KoneFly/eg4s20bg256-media-terminal/visual/pcb_sketch_renderer/reference/golden_overview.png

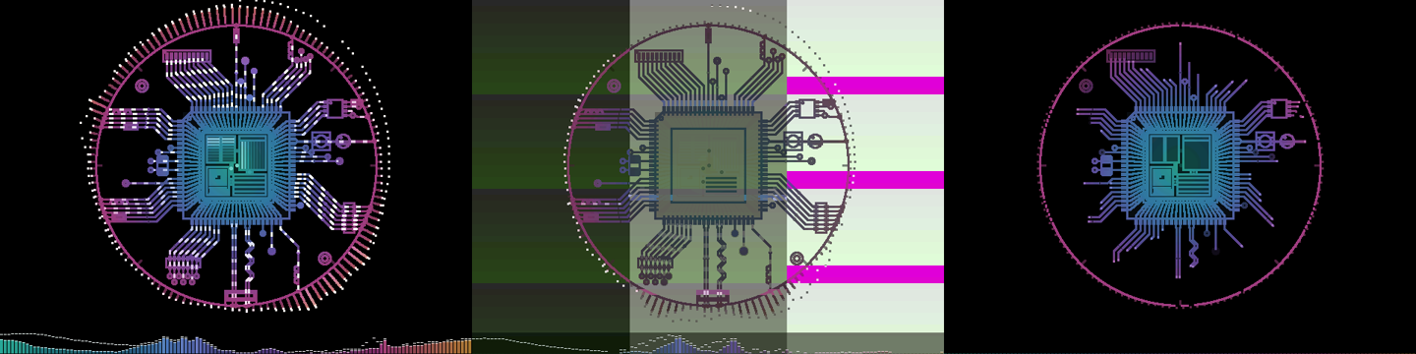
visual/pcb_sketch_renderer/reference/golden_overview.png
