KoneFly/eg4s20bg256-media-terminal/visual/pcb_dynamic_layer/doc/output/RESOURCE_REFACTOR_REPORT.md

# pcb_dynamic_layer W2 多周期资源重构记录

> 最后核对日期：2026-10-04  
> 维护者：pcb_dynamic_layer 执行方  
> 当前范围：W2 多周期版；W1 已归档出列。

用户批准移除超重的 W1，当前只投入 W2：长组合链切分为实际多拍，复用同构算术及工作缓冲，保持原 no_particles_v2 和 T1/T2 协议。

共享谱读注册、一个 DSP、9bit rise/fall 减法器、串行除法和读改写记录缓冲；配置集中限幅，按可达范围收敛内部位宽。ROM/地址规划保持等价，没有缩减柱数、三槽脉冲、四个彗星或改黄金。

最终最小硬门禁通过，4000 LUT 优化目标未达到。四轮原始 TD、具体数字、时序、告警和拍数统一登记于 W2_MULTICYCLE_REPORT.md / sim/td_result_mc.json，不重复维护数值表。最小预算余量有限，仍待规格方核定落点。

当前交付是 W2 多周期 RTL 和独立综合级测量；不定板、不集成。W1 原实现/证据在 archive/v2，解析式绘制只列二期候选。原 V1/V2 重构报告均保留在历史归档。

状态更新、RAM、黄金/TB 与归档各自职责清楚；共享算术、配置及记录缓冲减少重复。实现围绕本轮资源与时序门禁，没有增加未来绘制预留功能。
