KoneFly/eg4s20bg256-media-terminal/docs/中继板规格_v1冻结与v2设计.md

# 中继板规格（v1 冻结 + v2 设计）

> **合并版 2026-10-23**：本文件 = `音频采集板要求.md`（v1 冻结设计书）+ `麦克风中继板v2规格_20261020.md`（v2 设计）
> **第一部分 = v1 冻结引脚与板级要求（SSOT）**；**第二部分 = v2 改进设计**
> ⚠️ 引脚分配以第一部分为准，v2 不得改动

---

# 第一部分 · v1 冻结设计（原 `音频采集板要求.md`）

# 音频采集中继板需求（四路 I2S 数字麦克风）

> 更新 2026-10-14 ｜ 形态 = **四路 I2S 麦克风中继板**（**直接插到主板「连接器 J1」**）
> 状态：**供画中继板使用**；标【待确认】的项需先定值再落版。

---

## 1. 本方案内容

- 只做**一块四路中继板**：**1 个 2×20 母座插到「连接器 J1」** + **4 个 `INMP441` 模块座** + 去耦 + `SD` 下拉。
- **不画麦克风芯片板** —— 不做裸芯片贴装、不做模拟前端、不做板上声学开孔（进音由模块自身决定）。
- **不放任何 codec / DAC 芯片。**
- **输出侧不在本板**：扬声器现有 FPGA 板上已有，见 §8。
- 合规口径：麦克风属**传感器**；

---

## 2. 器件（**已定：`INMP441` 模块**）

| 项 | 手册值 | 对我们的意义 |
|---|---|---|
| 接口 | **24 bit 标准 I²S** | 直接进 FPGA，无需解调 |
| **供电** | **1.62 ~ 3.63 V** | **3.3 V 直供，免 LDO** |
| 电流 | 2.2 mA @3.3 V | 4 颗约 9 mA、8 颗约 18 mA |
| SNR / 灵敏度 | 61 dBA / −26 dBFS | 优于片内 ADC 的 8 bit |
| **`SCK` 频率** | **0.5 ~ 3.2 MHz** | 3.07~3.13 MHz（48 k×64）**已用掉上限的 96~98%** ⇒ 时钟质量必须保证（见 §4-C2） |
| **`WS` 频率** | **7.8 ~ 50 kHz** | 48 kHz 在范围内 |
| 数字电平 | V_IH ≥ 0.7×V_DD、V_IL ≤ 0.25×V_DD | 3.3 V 下与 J1 **直连兼容** |
| **群延迟** | **359 µs @48 kHz** | 频谱分析无所谓；**做 ANC / 音画同步须计入** |
| 数字滤波 | 内置高通 + 低通 | Q4 现场采集用；**内置滤波不构成"算法外包"**（见 §1 合规口径） |
| 进音 | **底部进音**（4.72×3.76×1 mm） | **⇒ 进音面朝向必须在装配时确认，见 §4-E1** |

**模块引出 6 脚**：`VDD` / `GND` / `SCK` / `WS` / `SD` / `L/R`（**`CHIPEN` 未引出，应为模块内部已使能** —— 见 §10）。

**`L/R` 接法**：本方案各麦**独占一根 `SD`** ⇒ **`L/R` 一律接 GND**（占左时隙），FPGA 只读左时隙。

**为什么不"一左一右"**：`L/R` 只决定"数据在 I2S 帧的**哪个半周期**推上线"，**不产生立体声**（INMP441 是单声道麦）。一左一右**唯一的作用是让两颗麦共用一根 `SD` 线（省线）**；各自独占 `SD` 时，左右只是换个时隙，**数据完全一样、效果不会更好**。J1 有 36 路而本板只用 9 个，**不缺线 ⇒ 不为省 2 根线引入分时解复用的复杂度**。

---

## 3. 接口与连线

**模块脚名对照**：模块的 `SCK` = 我们的 **`BCLK`**（位时钟）；`WS` = **`LRCK`**（帧时钟）；`SD` = 数据；`L/R` **接 GND**。**接 J1 的脚位见 §12.2。**

```text
FPGA --BCLK(位时钟)--+----+----+----+    两线共享
FPGA --LRCK(帧时钟)--+----+----+----+
                     |    |    |    |
                   [麦1][麦2][麦3][麦4]
                     |    |    |    |
FPGA <--SD0----------+    |    |    |    各麦各自一根数据线
FPGA <--SD1---------------+    |    |
FPGA <--SD2--------------------+    |
FPGA <--SD3-------------------------+
```

各麦共享同一对 `BCLK`/`LRCK` ⇒ **同一时刻采样，是真正的同时采样**。

**【必办】每根 `SD` 必须对地下拉**：麦在不驱动的那半周期 `SD` **呈高阻 ⇒ 线浮空**，会造成不确定读数与输入缓冲额外翻转电流。**中继板上给每根 `SD` 加 `100 kΩ` 对地下拉**（或改由 FPGA 内部弱下拉，二选一）。同时 **FPGA 侧只在左时隙采样**。

---

## 4. 中继板设计要求（**重点**）

### A. 电气安全

| # | 事项 |
|---|---|
| **A1【致命】** | **照实物缺口核对第一脚方向** —— 手册原文：**J1 第一脚在正方向左上**（J2 在**右下**，两口相反）。**插反 = 5 V / 3.3 V 灌进 IO ⇒ 可能烧 FPGA** |
| **A2【致命】** | **脚 11 是 5 V，一个 IO 都不许接**；取电只能用**脚 29（3.3 V）**。即使模块标注可用 5 V，**也只用 3.3 V** |
| **A3【致命】** | **模块座方向不能反** —— 模块丝印为 `GND VDD SD`（上排）/ `L/R WS SCK`（下排）；**座子接反 = VDD/GND 对调 ⇒ 烧模块**。逐块照丝印核 |
| A4 | **不要带电插拔**（J1 无保护电路） |

### C. 信号完整性

| # | 事项 |
|---|---|
| **C1** | **每根 `SD` 加 100 kΩ 下拉**（见 §3） |
| **C2【注意】** | **`BCLK` 余量极小**（3.07~3.13 MHz vs 手册上限 3.2 MHz）⇒ **源端串 22~33 Ω**、避免长支线、**不与 `SD` 长距离并行** |
| C3 | **回流路径连续**：不在 `BCLK`/`SD` 下方开槽；保留**完整地平面** |
| C4 | **不需要等长** —— 3 MHz 在板级属低频段，走线差折算到时间是亚纳秒量级，抠等长是白费功夫 |

### D. 电源与去耦

| # | 事项 |
|---|---|
| D1 | **每颗麦 `100 nF` 紧靠 `VDD`**（位置比容值重要）；中继板另加 **1 颗 `10 µF`** 作板级储能 |
| D2 | **3.3 V 电流要实测**：4 路约 9 mA、8 路约 18 mA；**手册未给脚 29 的电流指标** ⇒ 首次上电测该脚电压跌落【待确认】 |
| D3 | **J1 只有 2 个 GND（脚 12、30）** ⇒ 4~8 颗麦的回流都挤这两个脚。**可选**：在中继板上把若干空闲脚并联接 GND 增加回流 —— 但**那样 FPGA 侧这些脚必须保持未使用、不得被固件驱动**（须与固件方约定） |

### E. 声学与机械

| # | 事项 |
|---|---|
| **E1【致命】** | **先肉眼确认模块的进音面** —— INMP441 是**底部进音**（声音从芯片**背面**进）。若模块把芯片贴在板正面，则**进音孔在模块朝下那一面** ⇒ **中继板对应位置必须开孔、或让模块与中继板之间留出空腔**，否则**进音被堵、灵敏度骤降** |
| E2 | **四颗朝向一致**（不一致会造成通道间幅相差异） |
| E3 | **别把进音面贴死在桌面/机箱上**，留出进音空间 |
| E4 | **排针受力**：中继板靠 J1 一排针悬空支撑 ⇒ 建议加**支撑柱/定位孔**或控制悬臂长度，别让模块重量全压在排针上 |
| E5 | **模块间距**：留出各自进音空腔，不互相遮挡 |

### F. 可测性与可扩展

| # | 事项 |
|---|---|
| F1 | **留测试点**：`BCLK`、`LRCK`、**每根 `SD`** 各留一个测试焊盘（调试必用示波器/逻辑分析仪） |
| F2 | **一并引出 8 路**：SD4~SD7 = 脚 **21（G16）/ 23（K15）/ 25（H15）/ 27（K16）**，与备用 GND 一起引到排针 ⇒ 以后扩 8 路不用重画 |
| F3 | **丝印**：每个模块座旁标 `MIC1~4` 与六脚定义；板上标 `J1(连接器)` 与**第一脚三角标记** |

### G. 器件与工艺

| # | 事项 |
|---|---|
| G1 | **ESD**：MEMS 麦是静电敏感器件（手册有 ESD CAUTION）⇒ 焊接/装配做静电防护 |
| G2 | **首版用座子**（便于换型号/换位置），不直焊 |
| G3 | **引脚总数核对**：`BCLK` 1 + `LRCK` 1 + `SD` 4 + 3.3 V 1 + GND 2 = **9 个脚**（另加 4 个下拉电阻与去耦） |

---

## 5. 规模与扩展

- 首版 **4 路**（`SD0~SD3`）；
- **板上同时引出 `SD4~SD7`**（脚 21/23/25/27）⇒ 可扩到 **8 路**；
- 上限 8 路（FPGA 侧接收逻辑与数据线数均充裕）。

---

## 6. 电源

3.3 V 单电源（J1 脚 29），**不需要高精度基准**；中继板保留完整地平面。

---

## 7. FPGA 侧接口约定（了解即可，不需实现）

- `BCLK` / `LRCK`：由 FPGA 从 50 MHz 分频产生，**全通道共享**；名义 48 kHz 量级，实际速率随分频比（**现有音频链本就用非标准速率，不是新问题**）。
- 接收：**一份 I2S 接收器**（`BCLK`/`LRCK` 计数 + 每通道一个移位寄存器），**按 `LRCK` 取左时隙**，送入频谱链。
- **不需要 CIC 抽取滤波** —— I2S 麦内部已输出 PCM。
- 数据格式（标准 I2S / 左对齐、MSB 位置）**按所选型号手册对齐**。
- 硬件只需保证：**时钟干净、电源干净、走线合理**。

---

## 12. J1 引脚分配（**连接器 J1**）

### 12.1 概况

| 口 | 网络名 | IO 数 | 电源脚 | 地脚 | 状态 |
|---|---|---|---|---|---|
| **J1** | `GPIOA_0` ~ `GPIOA_35` | 36 | 脚 11 = 5V，脚 29 = 3.3V | 脚 12、30 | **本板使用** |
| J2 | `GPIOB_0` ~ `GPIOB_35` | 36 | 同上 | 同上 | **全空，备用** |

2×20 IDC（40 脚），**IO 电平 3.3 V**；板内到 FPGA 按差分等长走线，**本板用单端，不需要差分对**。

**占用情况**：本项目已用引脚（HDMI-B、TF、按键、拨码、LED、晶振、复位、DDC，以及双板链路用的 **HDMI-A 连接器**）**没有一个落在 J1 / J2 上**。

### 12.2 四路分配（含 8 路预留）

| 用途 | J1 脚位 | 网络名 | FPGA 球脚 |
|---|---|---|---|
| **`BCLK`**（位时钟，共享） | **1** | `GPIOA_0` | **D14** |
| **`LRCK`**（帧时钟，共享） | **3** | `GPIOA_2` | **G12** |
| **MIC1 `SD`** | **5** | `GPIOA_4` | **H13** |
| **MIC2 `SD`** | **7** | `GPIOA_6` | **J14** |
| **MIC3 `SD`** | **9** | `GPIOA_8` | **K12** |
| **MIC4 `SD`** | **13** | `GPIOA_10` | **M14** |
| MIC5 `SD`（预留） | 21 | `GPIOA_18` | G16 |
| MIC6 `SD`（预留） | 23 | `GPIOA_20` | K15 |
| MIC7 `SD`（预留） | 25 | `GPIOA_22` | H15 |
| MIC8 `SD`（预留） | 27 | `GPIOA_24` | K16 |
| **3.3 V 取电** | **29** | VCC_3V3 | — |
| **GND** | **12**、**30** | GND | — |

**⇒ 6 根信号全在奇数脚（1/3/5/7/9/13），一列排完，走线最省。**

### 12.3 J1 完整对照（**左列 = 奇数脚，右列 = 偶数脚，自上而下**）

| 左列 | 右列 |
|---|---|
| **1** `GPIOA_0` **D14** —— **`BCLK`** | **2** `GPIOA_1` G11 —— 备用 |
| **3** `GPIOA_2` **G12** —— **`LRCK`** | **4** `GPIOA_3` F13 —— 备用 |
| **5** `GPIOA_4` **H13** —— **MIC1 `SD`** | **6** `GPIOA_5` H14 —— 备用 |
| **7** `GPIOA_6` **J14** —— **MIC2 `SD`** | **8** `GPIOA_7` J13 —— 备用 |
| **9** `GPIOA_8` **K12** —— **MIC3 `SD`** | **10** `GPIOA_9` L14 —— 备用 |
| 11 `VCC5V` —— **【禁接】** | **12 `GND`** —— **回地（必接）** |
| **13** `GPIOA_10` **M14** —— **MIC4 `SD`** | 14 `GPIOA_11` P11 —— **留空（ADC 球脚）** |
| 15 `GPIOA_12` L10 —— **留空（ADC 球脚）** | 16 `GPIOA_13` M10 —— **留空（ADC 球脚）** |
| 17 `GPIOA_14` D16 —— 备用 | 18 `GPIOA_15` E15 —— 备用 |
| 19 `GPIOA_16` F14 —— 备用 | 20 `GPIOA_17` F15 —— 备用 |
| **21** `GPIOA_18` **G16** —— MIC5（预留） | 22 `GPIOA_19` G14 —— 备用 |
| **23** `GPIOA_20` **K15** —— MIC6（预留） | 24 `GPIOA_21` J16 —— 备用 |
| **25** `GPIOA_22` **H15** —— MIC7（预留） | 26 `GPIOA_23` H16 —— 备用 |
| **27** `GPIOA_24` **K16** —— MIC8（预留） | 28 `GPIOA_25` M16 —— 备用 |
| **29 `3.3V`** —— **取电（必接）** | **30 `GND`** —— **回地（必接）** |
| 31 `GPIOA_26` M15 —— 备用 | 32 `GPIOA_27` L16 —— 备用 |
| 33 `GPIOA_28` N16 —— 备用 | 34 `GPIOA_29` N14 —— 备用 |
| 35 `GPIOA_30` P16 —— 备用 | 36 `GPIOA_31` P15 —— 备用 |
| 37 `GPIOA_32` R16 —— **留空（ADC 球脚）** | 38 `GPIOA_33` R15 —— 备用 |
| 39 `GPIOA_34` T15 —— 备用 | 40 `GPIOA_35` R14 —— 备用 |

---

# 第二部分 · v2 设计规格

# 麦克风中继板 v2 设计规格（2026-10-21 定稿）

> **签发**：浮浮酱（架构方）｜ **执行**：硬件队友
> **依据**：`docs/音频采集板要求.md`（v1 设计书）+ 2026-10-20/21 现场实测结论
> **状态**：**v1 已装机运行正常**；v2 为改进版，**不改任何 FPGA 引脚分配**
> **本文覆盖：引脚、布局、间距、信号完整性、电源、机械、丝印、测试点**

---

## 0. ⛔ 铁律：引脚分配一位都不能改

**依据（R32 实测失败）**：仅把 `audio_din` 从 G16 改到 P4 ⇒ **Setup 0.211 → 0.132 ns**，欠门禁 0.068，直接 FAIL、无 bit。

| 信号 | J1 脚 | 球脚 | 方向 |
|---|---|---|---|
| **BCLK**（共享） | **1** | **D14** | FPGA → 模块 |
| **LRCK**（共享） | **3** | **G12** | FPGA → 模块 |
| **MIC1 `SD`** | **5** | **H13** | 模块 → FPGA（**ANC 误差麦**） |
| **MIC2 `SD`** | **7** | **J14** | 模块 → FPGA |
| **MIC3 `SD`** | **9** | **K12** | 模块 → FPGA |
| **MIC4 `SD`** | **13** | **M14** | 模块 → FPGA |
| **DIN**（功放输出） | **21** | **G16** | **FPGA → 功放（输出！）** |
| 3.3 V | 29 | — | 电源 |
| GND | 12、30 | — | 电源 |

**⚠️ G16 已从「MIC5 预留输入」改为「DIN 输出」** ⇒ 第 5 个麦克风**绝不能**接 J1-21。

---

## 1. 保留 v1 的全部设计

| 项 | 说明 |
|---|---|
| **J1 2×20 母座** | ⚠️ **第一脚在正方向左上**，板上必须有三角标记 |
| **4 个 INMP441 模块座** | 六脚丝印：上排 `GND VDD SD`／下排 `L/R WS SCK` |
| **每路 `SD` 的 100 kΩ 下拉** | 麦克风半周期呈高阻，必须下拉 |
| **每模块 VDD 就近 0.1 µF 去耦** | 见 §6 |
| **进音开孔 / 空腔** | ⚠️ INMP441 **底部进音**，孔在芯片朝下那面 |
| **四颗朝向一致** | 避免通道间幅相差异 |
| **支撑柱** | 别让模块重量全压在排针上 |
| **丝印** | 每座旁标 `MIC1~4` + 六脚定义 |

---

## 2. ⭐ 新增 A：功放接口（2×4 排针，丝印 `AMP`）

### 2.1 排针定义

| 脚 | 信号 | 说明 |
|---|---|---|
| 1 | BCLK | ← J1-1 |
| 2 | LRCK | ← J1-3 |
| 3 | **DIN** | ← **J1-21（G16）** |
| 4 | GND | ← J1-12/30 |
| 5 | 3.3 V | ← J1-29（供 SD 选择） |
| 6 | **SD 分压点 1.055 V** | 见 §2.3 |
| 7 | GND | 电源回路 |
| 8 | 备用 | 预留第二个功放 |

### 2.2 扩流与滤波（**必做**）

| 元件 | 值 | 位置 | 原因 |
|---|---|---|---|
| **电解电容** | **100 µF / 16 V** | 功放 VIN 与 GND 间，靠近接口 | D 类功放电流脉冲大，压降会带出「嗡嗡」声 |
| **陶瓷电容** | **0.1 µF** | 同上，紧邻 | 高频去耦 |
| **串阻** | **22~33 Ω** | BCLK / LRCK / DIN 各一个，靠 FPGA 侧 | 抑制长线振铃 |

> v1 **没有**串阻，系统工作正常 ⇒ 属增强项；但 **v2 因负载增加（见 §2.2.1），建议改为必做**。
> 位号放 0402 焊盘，**兼容 0 Ω 跳线**（万一反而变差可直接短接）。

### 2.2.1 ⚠️ 四麦 + 功放后的 BCLK / LRCK 扇出

| 项 | v1（3 麦 + 1 功放 = 4） | **v2（4 麦 + 1 功放 = 5）** |
|---|---|---|
| BCLK 频率 | 3.07~3.13 MHz | 同 |
| 负载数 | 4 | **5** |
| 风险 | 可接受 | **扇出增加，必须串阻** |

> 依据：`音频采集板要求.md` **§C2** —— BCLK 余量极小（3.07~3.13 MHz vs 手册上限 3.2 MHz）。

### 2.3 SD 分压与切换

**MAX98357A 的 `SD` 是电压门限选择，不是普通高低电平：**

| SD 电压 | 功能 |
|---|---|
| **< 0.16 V（GND）** | ⛔ **关断，完全无声** |
| 0.16 ~ 0.77 V | (L+R)/2 混合（听不出对比） |
| **0.77 ~ 1.4 V** | ✅ **右槽 = POST（滤波后）** |
| **> 1.4 V（3.3 V）** | ✅ **左槽 = RAW（滤波前）** |

**分压电路（板上固定焊接）**：

```text
3.3 V ── 100 kΩ ──┬── SD 分压点（1.055 V）
                  │
                47 kΩ
                  │
                 GND

标称 1.055 V；最坏偏差（±5%）0.935 ~ 1.185 V，仍在 0.77~1.4 V 内
```

**⚠️ 为什么不用 100k+33k**：标称 0.819 V 看似够，但最坏会掉到 **0.721 V**，跌破 0.77 V 门限 ⇒ 变成「(L+R)/2 混合」⇒ **听不出对比**。

**切换方式：单刀双掷拨动开关（SPDT，ON-ON）**

```text
              ┌── ① 3.3 V ──────→ RAW（滤波前）
   拨动开关 ──┤
              └── ③ 分压 1.055 V ─→ POST（滤波后）
                     │
                   ②（公共端）──→ 功放 SD
```

| 板上设计 | 说明 |
|---|---|
| 预留 **3P** 位 | `3.3V` / `SD` / `分压点`，可插开关或跳线帽 |
| 开关规格 | `SS-12D00` 类，**2 位 3 脚 ON-ON** |
| ⛔ 不要 ON-OFF-ON | 中间档 SD 悬空，音量异常 |
| ⛔ 不要引出 GND 档 | GND = 关断静音，容易误判为"功放坏了" |

> 不装开关时：跳线帽短接「3.3 V — SD」固定 RAW（保底演示够用）。

---

## 3. ⭐ 新增 A2：误差麦接口（6P 排针，丝印 `ERROR MIC`）

### 3.1 为什么必须走线缆

**ANC 要求误差麦与扬声器距离 3~8 cm**。若焊死在板上而喇叭在别处 ⇒ 距离不可控 ⇒ **ANC 完全失效**。

### 3.2 排针定义

| 脚 | 信号 | 来源 |
|---|---|---|
| 1 | **GND** | J1-12/30 |
| 2 | **VDD** | J1-29（3.3 V） |
| 3 | **SD** | **J1-5（H13）** |
| 4 | **L/R** | GND（固定左槽） |
| 5 | **WS** | J1-3（G12） |
| 6 | **SCK** | J1-1（D14） |

### 3.3 与其余三麦的关系

| 通道 | v2 形式 | 用途 |
|---|---|---|
| **MIC1** | ⭐ **6P 排针 + 线缆** | **ANC 误差麦（可移动）** |
| MIC2/3/4 | 板上模块座 | 三麦均值 |

> **RTL 依据**：`slave_audio_demo_top.v:236` 的 `mic_three_mean_t16` **只取 `pcm1/pcm2/pcm3`**，`pcm0`（MIC1）仅作调试输出 ⇒ **零冲突**。

**丝印必须写**：`ERROR MIC / ANC` + 「使用时放在扬声器前方 3~8 cm」+「不用时不插，不影响三麦均值」。

---

## 4. ⭐ 麦克风布局与间距（**v2 新增**）

### 4.1 核心矛盾

| 麦克风 | 位置由谁决定 | 要求 |
|---|---|---|
| **MIC1（误差麦）** | **扬声器的位置** | 离喇叭 **3~8 cm** |
| **MIC2/3/4（采集均值）** | **噪声场的位置** | **远离喇叭**（否则频谱被自己输出占满） |

**⇒ 两个要求相反。这正是不建议 MIC1 焊在板上的原因。**

### 4.2 间距要求（三层约束）

| # | 距离 | 要求 | 依据 |
|---|---|---|---|
| **1** | **MIC1 ↔ 扬声器** | **30 ~ 80 mm** | ANC 有效区仅在声源附近；`D-72` 账 6 的 500 Hz 相位预算允许 |
| **2** | **MIC2/3/4 ↔ 扬声器** | **≥ 150 mm** | 喇叭输出会直接进这三路，污染频谱 |
| **3** | **MIC1 ↔ 最近的 MIC2/3/4** | **≥ 100 mm** | 保证三麦在 ANC 安静区之外 |

### 4.3 三麦（MIC2/3/4）内部排布

| 项 | 建议 |
|---|---|
| 两两间距 | **30 ~ 50 mm** |
| 排布 | **三角形**（非直线 —— 直线易同相叠加） |
| 朝向 | 四颗**完全一致** |
| 与噪声源距离 | 大致相等，避免某一路偏响拉偏均值 |

### 4.4 若强行全部上板：板长需要 ≥120 mm

| 板长 | 可实现的 MIC1↔MIC2 距离 | 评价 |
|---|---|---|
| 60 mm | ≈ 45 mm | ❌ 不够 100 mm |
| 80 mm | ≈ 65 mm | ⚠️ 勉强 |
| 100 mm | ≈ 85 mm | 🟡 接近 |
| **120 mm** | ≈ 105 mm | ✅ 达标 |

**布局示意**：

```text
        ┌──────────────────────────────────┐
        │  ●MIC2        ●MIC3              │  三麦区
        │                                  │  （三角形）
        │  ●MIC4                           │
        │                                  │
        │  ═══════════ 分隔带 ═══════════   │  间距 ≥100 mm
        │                                  │
        │                        ●MIC1     │  误差麦区
        └──────────────────────────────────┘
                                  ↕ 30~80 mm
                              [ 扬声器 ]
```

**⇒ 推荐仍是 §3 的「MIC1 走线缆」，板长可回到 60~80 mm。**

---

## 5. ⭐ 信号完整性（**v2 强化**）

| # | 规则 | 原因 |
|---|---|---|
| **S1** | **BCLK / LRCK 源端串 22~33 Ω**（靠 FPGA 侧） | 频率 3.07~3.13 MHz，上限 3.2 MHz，余量极小 |
| **S2** | **走线尽量短**（<20 mm 至各模块座） | 长支线造成振铃/过冲 |
| **S3** | **`SD` 不得与 `BCLK` 长距离并行** | BCLK 会耦合进高阻的 SD |
| **S4** | **保持完整地平面** | 不在 BCLK/SD 下方开槽，保证回流连续 |
| **S5** | **不需要等长** | 3 MHz 在板级属低频段，差折算到时间是亚纳秒量级，抠等长是白费功夫 |
| **S6** | **每路 `SD` 留 100 kΩ 下拉** | 半周期高阻，防浮空 |
| **S7** | **功放 BCLK/LRC 分支也要串阻** | 与 §2.2.1 的 5 负载配合 |

---

## 6. ⭐ 电源与去耦

| # | 项 | 规格 |
|---|---|---|
| **P1** | 麦克风供电 | **3.3 V 单电源**（INMP441 宽压 1.62~3.63 V，免 LDO） |
| **P2** | 每模块去耦 | **0.1 µF**，紧贴 `VDD`-`GND` |
| **P3** | 总入口去耦 | **10 µF 电解 + 0.1 µF 陶瓷** |
| **P4** | **功放不从中继板取电** | 功放 VCC 走**独立 5V**（USB 只有 500 mA，功放峰值 **≈0.73 A**） |
| **P5** | **功放 VIN 就近去耦** | **100 µF + 0.1 µF**（§2.2） |
| **P6** | ⛔ **J1-11（VCC5V）绝不接任何线** | 致命（A2） |

**⚠️ 为什么功放不能用 FPGA 的 5V**：
1. 本板**只能 USB 供电**（板卡手册），USB 2.0 = **500 mA @ 5 V = 2.5 W**
2. 功放峰值 **0.73 A** ⇒ 单项就超容量
3. D 类功放电流脉冲会污染 5V 轨 → 经 LDO 传入 FPGA 的 3.3V → **时序劣化 / 音频自激**

---

## 7. ⭐ 新增 B：把剩余 IO 全部引出

| 类别 | J1 脚 | 引出方式 |
|---|---|---|
| 已用功能脚 | 1/3/5/7/9/13/21 | 正常接线 |
| **备用 MIC5~8** | **23 / 25 / 27** | 3P 排针 + GND（**21 已给 DIN**） |
| **普通 GPIO** | 2/4/6/8/10/17/18/19/20/22/24/26/28 | **2×7 排针** |
| 电源 | 12 / 29 / 30 | 3.3 V × 2 + GND × 2 |
| ⛔ **VCC5V** | **11** | **绝不引出** |
| ⛔ **ADC 球脚** | **14（P11）/ 16（M10）** | **留空不引出** |

**丝印**：每个引出排针旁标 **J1 脚号 + 球脚号**（如 `23/K15`）。

---

## 8. ⭐ 新增 C：测试点

| 测试点 | 形式 | 用途 |
|---|---|---|
| **BCLK / LRCK** | 测试焊盘 | 验证 3.07~3.13 MHz / 48 kHz |
| **每路 SD（MIC1~4）** | 测试焊盘 | 确认四麦都有数据 |
| **DIN（G16）** | 测试焊盘 | ⭐ 确认 I2S 输出有波形（功放不响时第一查这个） |
| **SD 分压点** | 测试焊盘 | 验证 1.055 V（误差 <5% 才装机） |
| **GND 测试柱** | **大焊盘或铜柱** | ⭐ **示波器探针接地，必须有** |

---

## 9. ⭐ 机械与工艺

| # | 项 | 要求 |
|---|---|---|
| **M1** | **进音开孔 / 空腔** | 每颗模块对应位置开孔或留空腔，**不能用双面胶封死进音面** |
| **M2** | **支撑柱** | 中继板靠 J1 一排针悬空支撑 ⇒ 加支撑柱/定位孔，别让模块重量全压在排针上 |
| **M3** | **四颗朝向一致** | 上下不能反 |
| **M4** | **ESD 防护** | MEMS 麦是静电敏感器件，焊接/装配做静电防护 |
| **M5** | **首版用座子** | 便于换型号/换位置，不直焊 |
| **M6** | **模块间距** | 留出各自进音空腔，不互相遮挡 |

---

## 10. ⚠️ 五条必须写进丝印的提醒

| # | 提醒 | 后果 |
|---|---|---|
| **A1** | **J1 第一脚在正方向左上** | 插反 = 5 V / 3.3 V 灌进 IO ⇒ **烧 FPGA** |
| **A2** | **J1-11 是 VCC5V，一个 IO 都不许接** | 短路 |
| **A3** | **模块座方向不能反** | VDD/GND 对调 ⇒ **烧模块** |
| **A4** | **J1-21（G16）是输出（DIN）** | 接麦克风会与输出对顶 ⇒ **可能烧器件** |
| **A5** | **误差麦（ERROR MIC）使用时要靠近扬声器 3~8 cm** | 距离不对 ANC 无效 |

---

## 11. 不改的部分（明确边界）

| 项 | 状态 |
|---|---|
| FPGA 引脚分配 | ⛔ **一位不改** |
| MIC 数量 | 4 路（MIC1~4） |
| BCLK / LRCK 频率 | 3.07~3.13 MHz / 48 kHz |
| I2S 采样率 | 48,076.923 Hz |
| 麦克风供电 | 3.3 V 单电源 |

---

## 12. ✅ 打样前检查清单

**电气**
- [ ] J1 第一脚位置正确（左上），有三角丝印
- [ ] MIC1~4 的 `SD` 各接 100 kΩ 下拉
- [ ] 每模块 VDD 就近 0.1 µF
- [ ] 总入口 10 µF + 0.1 µF
- [ ] BCLK/LRCK 串阻位已留（22~33 Ω，兼容 0Ω）
- [ ] 功放 VIN 100 µF + 0.1 µF
- [ ] SD 分压 100k + 47k（**不是 33k**），测点预留
- [ ] J1-11 未引出、未接线
- [ ] ADC 球脚（14/16）留空

**接口**
- [ ] `AMP` 2×4 排针，脚位与 §2.1 一致
- [ ] `ERROR MIC` 6P 排针，脚位与 §3.2 一致
- [ ] 扩展 IO 排针已引（含 MIC5~8 的 23/25/27）
- [ ] 测试点：BCLK / LRCK / 4×SD / DIN / SD 分压点 / GND 柱

**机械**
- [ ] 进音开孔/空腔
- [ ] 支撑柱位
- [ ] 模块座丝印 `MIC1~4` + 六脚定义

**上电前**
- [ ] 只用 3.3V 供电验证：量 J1-29 = 3.2~3.35 V
- [ ] 量 SD 分压点 = 1.0~1.1 V
- [ ] 量 `mic_bclk` 波形 = 3.07~3.13 MHz（**首件必做，映射错会误判**）

---

*浮浮酱 ｜ 2026-10-21 ｜ 引脚不动、间距够远、地要干净、丝印要醒目。*
