KoneFly/eg4s20bg256-media-terminal/docs/网站名称简介_已提交版_20261028.md

# 作品名称与简介 · 已提交版（2026-10-28）

> **状态**：✅ **已于 2026-10-28 提交**
> **⚠️ 本文件是最终对外口径** —— 报告、视频、答辩都必须与此一致

---

## 作品名称

> **今非昔比 · 多媒体对比终端**

---

## 作品简介（472 字）

本作品以安路 EG4S20BG256 为平台，单板即构成完整多媒体终端，双板联用形成现场采集与画面回放的对比闭环，全部算法在 FPGA 内实现，不含任何处理器。主板从 TF 卡读取 BMP 图片与 WAV 音频，经自研 SD/SPI 读卡、FAT32 只读解析、片上 SDRAM 帧缓冲与最近邻重采样后，输出 640×480 HDMI 视频与 48 kHz I2S 音频，支持八槽双层图片墙预览与全屏大图切换、三级分辨率缩放、淡入淡出与擦除与幕布等可开关转场、1 至 60 秒可调自动轮播与仪表盘显示，换卡后按键即可重载生效。副板以 I2S 接收四路数字麦克风，三路均值融合、另一路作误差检测，经 150 Hz 至 2 kHz 四节带阻滤波后执行 4096 点 FFT，将滤波前后两条同索引频谱回传主板与画面同屏显示；同一信号按 I2S 双槽送外接功放，实现处理前后的听感对比。在此基础上，系统还能对单一频率的稳态噪声做自适应反相相消，在扬声器前方数厘米处生成反相信号，形成电域整形与声学相消两级处理。板间以一根 HDMI 线缆承载串行信号，不使用 HDMI 协议。作品以对比为核心：一是现场声与回放声并置，二是处理前后的频谱与听感同显，适合设备噪声治理、展陈与巡检等场合。

---

## ⚠️ 报告与视频必须遵守的边界

| # | 简介说了 | 报告/视频 |
|---|---|---|
| 1 | 淡入淡出、擦除、幕布 | ✅ 可演示这三类；⛔ **不能说"模糊化"** |
| 2 | 换卡后按键重载生效 | ✅ 可在**受控换卡段**演示；⛔ **不演"读取中拔卡"** |
| 3 | 单一频率的稳态噪声 | ✅ 只演示单频（500 Hz）；⛔ 不称"宽带降噪" |
| 4 | 数厘米处 | ✅ 只声称固定测点；⛔ 不称"整个房间" |
| 5 | 不使用 HDMI 协议 | ✅ 双板链路是自有串行协议 |
| 6 | 未给 ANC 的 dB 数 | ✅ 视频不承诺数字；报告可写实测约 3~5 dB 并注明条件 |

---

*浮浮酱 ｜ 2026-10-28 ｜ 已提交，口径锁定。*
