KoneFly/eg4s20bg256-media-terminal/visual/m6_full_display_integration/START_PROMPT.md

# M6 完整显示链集成（M6-FDI）· 启动提示

> **签发**：浮浮酱（规格/架构方）｜ **日期**：2026-10-04
> **授权**：主人裁定——不等 052 进度总结，视觉线先行；"后续能否直接集成完整" ⇒ **本包一次做完整**。
> **状态**：单包任务（方案评审 → 合体 → TD → bit → 上板，途中不切包）。

---

## 1. 目标

在 **052 第四步主板树快照**上一次性补齐 M6 显示链的两块缺口，产出"**完整 M6 显示位**"：

```
副板 7175ECC3（FFT，不动）→ 帧快照（三银行，已有）
        ↓
【W2 pcb_frame_updater】→ T1/T2 真双口表（pcb_state_mem）→ S2 pcb_pixel_renderer
        ↑
【标签图链：SDRAM 载入 + 行区段表读取 → in_label 供给】
        ↓
     HDMI 单屏输出：PCB 线稿（环/走线/元件/芯片/音柱）
                + 状态驱动动态（生长/电流/脉冲/节点/彗星/音柱高度与峰值帽）
                + 底部常驻 128 柱
```

**不含**（明确边界）：TF 真音频（第五步，另排）、043 主线合体（终态另行）、粒子与柱顶连线（已裁）、W1（已出列）。

## 2. 基座与资产（只读引用；一律复制到本任务工作区后再改）

| 资产 | 路径 | 用途 |
|---|---|---|
| 工程基座 | `iccoder_workspace/tasks/task_052_ethernet_pcm_link/td_run/v9_display_20261004_final2/`（位 75959E68，含 `vendor/m6_s2/` 全套） | 集成目标树 |
| W2 交付 | `visual_workspace/rtl_handoff/pcb_dynamic_layer/`（多周期版 4492 LUT，正式端口与 V2 冻结一致） | 焊入 |
| 标签图本体 | `visual_workspace/golden/pcb/PCB.BMP`（640×480×16bit，614400B） | 载入 SDRAM |
| 逐行区段表 | `visual_workspace/golden/pcb/rom/rom_row_span.hex` | 标签读取加速（见 PORTING_PLAN） |
| 设计依据 | `visual_workspace/spec/M6_PCB_PORTING_PLAN.md`（S6a/S6b 节）、`visual_workspace/INTERFACE_CONTRACT.md` §9 | **已冻结设计；本包只做"目标树由 043 主线改为 052 第四步树"的适配**，不重新发明 |
| 借鉴资产（只读参考，按需裁剪移植） | 043/056 的 SDRAM 控制器与 TF/FAT32 链；052 第五步的 TF 读链 | 载入路径实现 |

**硬边界**：不改 052 通信应用层（`v9_spectrum_snapshot` 三银行帧快照为输入）；不改副板 7175ECC3；不碰 043 主线与任何已验收位文件。

## 3. 工作项

### 3.1 方案评审（唯一中途 checkpoint：先出 1 页，规格方确认后实施）

必须包含：

- **标签图载入路径**：候选 = TF→SDRAM（裁剪复用 043/第五步资产，仅"读文件→写 SDRAM"窄路径）；或其他更简方案。给出选择理由；
- **资源预算**（全量：LUT/REG/ERAM9K/32K/DSP/PLL）——目标 **总占用 ≤90%**；**超预算即停、报告待裁定，不得静默裁规格**；
- **引脚冲突核查**：SDRAM/新增引脚 vs 现有网口/HDMI 的 `.adc` 分配（板上多外设共存，官方 lab_ex_6 为共存先例）；
- **行区段表读取链设计**：SDRAM 读仲裁（标签读 vs 其他访问）+ 行缓存 + `in_label` 供给，对齐显示扫描序与 `async_pixel_fifo` 同拍语义（S2 端口 `in_label`，见 `vendor/m6_s2/pcb_pixel_renderer.v`）。

### 3.2 W2 焊入

- 数据流：`v9_spectrum_snapshot`（三银行）→ **W2** → T1/T2（`pcb_state_mem` 真双口化）→ S2；
- 替换四步树内现有简易柱更新逻辑；W2 只经**冻结正式端口**交接；`frame_tick` 节拍语义与独立验证口径一致。

### 3.3 集成验证 + TD + 出位

- 集成台：W2 写口对拍（沿用独立黄金）+ T1/T2 表读写一致性 + S2 像素流完整性 + 标签流扫描序；
- 独立 TD：**0 违例**（Setup/Hold）；资源登记；告警如实 OPEN；
- 出 bit（登记 BURN_INDEX 由主人/浮浮酱走流程）。

### 3.4 上板验收（与主人配合）

判据：
1. 上电即见**完整 PCB 线稿**（环/走线/元件/芯片/音柱，无错位、无撕裂）；
2. 频谱输入下**动态可观察**：音柱起伏、峰值帽、走线电流、节点辉光、彗星；
3. 底部 128 柱随频谱动态；
4. 长时间运行稳定（≥10 分钟）。

## 4. 边界情况（必须防御）

- **标签图载入失败**（TF 缺失/校验不过）：明确告警落点（数码管/LED 码），不得静默黑屏；
- **SDRAM 读写竞争**：标签读取 vs 其他访问的仲裁与优先级定义；
- **帧快照异常**（epoch 跳变/副板重启）：W2 输入连续性的既有 epoch 机制延续；
- **静音输入**：画面全静态正确（线稿保持、动态归零、底部柱归零）。

## 5. 交付物

集成工程快照（含与基座的逐文件 diff）+ 方案评审 1 页 + 集成/TD 报告 + bit + 上板记录。
未验证项如实登记；**不代签验收**。

---

*浮浮酱 2026-10-04 ｜ 关联：`docs/DECISION_LOG.md` D-15/D-16/D-17*
