KoneFly/eg4s20bg256-media-terminal/visual/pcb_dynamic_layer/START_PROMPT.md

# pcb_dynamic_layer 当前入口：W2 多周期版

用户已批准 W1 整体出列，本包只剩 W2。请从 doc/brief/START_PROMPT.md 开始，并依次阅读其余三份当前 brief。

本轮 50MHz 综合级 Setup/Hold 零违例；TD #lut≤4500，争取≤4000；DSP≤2。黄金 no_particles_v2、T1/T2 写序与 commit/done 协议保持冻结。不定板、不集成。

本文件旧版及 V2 全包已归档至 archive/v2。当前交付报告：doc/output/W2_MULTICYCLE_REPORT.md。
