KoneFly/eg4s20bg256-media-terminal/visual/pcb_frame_updater/START_PROMPT.md

# 本包已合并 — 请使用 `pcb_dynamic_layer`

> 2026-10-02（浮浮酱）：按主人「后续设计尽量在一个任务包内完成」的裁定，
> 本包（S3 帧更新器）已与 `pcb_particle_overlay`（S2b 覆盖层光栅化）**合并**为：

```
visual_workspace/rtl_handoff/pcb_dynamic_layer/START_PROMPT.md
```

**请发送合并包的全文，不要发送本文件。**
