KoneFly/eg4s20bg256-media-terminal/visual/m6_full_display_integration/doc/output/BOARD_PROBE_A2_20261005.md

# M6-FDI 0x46 A2 实验交付（2026-10-05）

**状态：A2 已出位，真卡待实测；未宣称故障修复。原 6B810152 硬件 FAIL。**

位：`deliverables/M6_FDI_A2_20261005_7B97635A.bit`（636626 字节）。SHA256：`7b97635aadd6fa4ebab8f3fc598f195cde5bafcdf6b6968bf105ac62284cd57c`。
实验源及原始证据：`experiments/board_0x46_A2_work/`；最终 TD：`td_run/bit_a2_final/`。

本次加载功能改动仅将 MISO 四级 EG_LOGIC_BUF 缩至两级。诊断为 ERROR 前一拍快照，通过只读输出端口和临时 SW0 bank 显示；SPI/SDRAM 五个驱动仅增加可逆的只读端口，功能正文按原行尾格式重建后与原字节一致。94 个实验源文件核验；原 R2 400 项封存文件、81 项受保护上游资产身份核验通过。W2/S2、CRC、卡格式、超时参数不变。不得偷偷恢复四级或再插额外 MISO 缓冲以抵消实验变量。

| 实测项 | 结果 |
|---|---|
| 物理 MSlice | 4695/4900，余量 205 |
| 物理 LUT / REG | 16234 / 11434 |
| ERAM9K / ERAM32K / DSP / PLL | 43 / 5 / 18 / 3 |
| Setup / Hold | +0.901ns / +0.021ns |
| Setup / Hold 违例 | 0 / 0 |
| CDC 精确端点 | 110 物理首级数据端 + 1024 多周期数据端，精确查询 1134 |
| CDC 别名 / pixel 误豁免 | 0 / 0 |
| ROM INIT | 512 行通过；不代表 bit 读回核验 |
| 模型 | 11 加载用例、2 看门狗快照用例通过；正常加载 24863814 拍，307200 像素 |
| lint | 加载/W2 严格 0 告警；应用接口 0 错误/343 告警 OPEN |

新增应用告警 `ready_value`：临时观测 bank 覆盖原 ready 诊断页，原探针输出未消费。其余历史告警保留原口径。正式资源与功能验收不由这些模型结果代签。

## 上板操作

1. 烧上述 SHA 对应位。SW0=1、P0 时确认 **d0 05462**；SW0 为原 ready bank 开关，页号仍为 SW[3:1]。
2. SW0=0，KEY1 复位并放开，记录错误码与屏幕；若有完整线稿，观察至少 10 分钟，记录动态运行、错位/撕裂、错误或重启。
3. 若失败，先保留故障现场。SW0=1 读取 **P1..P7**，切页后等至少 0.3 秒；回传末五位十进制读数及原错误码。进入 ERROR 前一拍已冻结，切页不会清除。
4. 页位定义与解码见 `experiments/board_0x46_A2_work/doc/output/BOARD_PROBE_A2.md` 和 `scripts/decode_probe_pages.py`。再作 KEY1 复现，记录结果。

尚无 A2 真卡烧录、屏幕及稳定性观测记录，需主人上板回传。结果回来前不另改加载 RTL；INIT、SECTOR_START 或其他等待级由读数裁定。CARD/引脚已由规格方实证排除，不重复更改。BURN_INDEX 登记由主人/规格方按原流程执行。
