KoneFly/eg4s20bg256-media-terminal/visual/m6_full_display_integration/README.md

# M6-FDI 当前交付

第二轮受控LBA标签加载、面积收敛及精确CDC修复的当前结果见 [交付报告](doc/output/M6_FDI_ROUND2_REPORT.md)。

候选bit及SHA见 [位清单](deliverables/ROUND2_BIT_MANIFEST.json)；受控TF标签/PCM布局与PC制作、写卡、读回步骤见 [受控卡流程](doc/output/CONTROLLED_TF_CARD_V2.md)。软件门禁通过，上板记录仍为NOT_STARTED，由主人配合；外部BURN_INDEX待主人/规格方登记。

[证据索引](doc/output/ROUND2_EVIDENCE_INDEX.json)绑定当前源快照、TD、验证、bit与卡工具。第一轮报告/证据以及reference/round1_fat32为历史，不作为当前签核。
