KoneFly/eg4s20bg256-media-terminal/visual/spectral_ridge_renderer/MOVED_TO_TASK_030.md

# 已正式立项 → **task_030**

> **2026-09-18**：本任务包已通过**中间检验**（验收方补齐 4 个规范字段），
> 并按 `visual_workspace/HANDOFF_WORKFLOW.md` **第 ⑤ 步「正式立项」**，移入并编号为：
>
> ## ➡️ `iccoder_workspace/tasks/task_030_spectral_ridge_renderer/`

## 本目录的定位

**视觉线留存的副本**（供追溯），**不再是工作副本**——
**实现方在 `task_030` 工作区开工**，本目录后续不再同步。

## 中间检验记录（验收方，2026-09-18）

| 检查项 | 结果 |
|---|---|
| 四份核心文档齐备 | ✅ |
| 场景可执行性（SR01~SR17）| ✅ 均有**可观察检查项** |
| **TB 独立性**（LESSON-001）| ✅ **明确要求"不读 DUT 内部" + "不得复制 DUT signed-diff 表达式"** |
| **黄金数据独立性** | ✅ JSON 标注 *"独立于浏览器逐像素实现"* + SHA256 |
| 变异设计 | ✅ 5 支，针对性强 |
| **规范必填字段** | ⚠️ **缺 4 项，已由验收方补齐**：`分层与时间预算` / `提速措施` / `边界与规模覆盖` / `时序要求` / `代码合规摘要`（**均为 2026-09-18 新增规范**）|

## 后续

- **实现方**（国模）→ 在 `task_030` 开工；
- **验收方** → 按 `ACCEPTANCE_SOP.md` 做结果验收（第 ⑦ 步）；
- **视觉线** → 模块交付后由视觉 agent 集成上板（第 ⑧ 步）。
