KoneFly/eg4s20bg256-media-terminal/visual/spectral_ridge_renderer/reference/UPSTREAM_FACTS.md

# M4 上游事实快照（2026-09-18）

| 文件 | SHA256 | 状态 |
|---|---|---|
| task020/constraints/visual_hdmi_top.adc | 35710A12A9721B45D9F591371E97F48CE25C9B6B54EE794C34C5FB8C2A931395 | 上板修复ADC |
| task024/rtl/audio_band_energy.v | AB569EFA00B9B30B14BF344B5147CCA7582BFB79AC2CDB5703D4CA81E1DC858B | 验收通过；2275LUT/837REG/4DSP |
| task025/rtl/color_glow_renderer.v | FFBA8EC14F12425DDBE597CCDC9644FE0DEB0DFCF2CD3C2E9BEAD29E9D0F18C1 | M3模块验收通过；583LUT/106REG |
| task021/rtl/demo_wav_source.v | B087556B497EF575074E7891D58C9D772EDFC85BA6903C194DDF3BD3E3BEA36E | 板载WAV合成源 |
| task021/rtl/wav_parser.v | FA709E9C47F1E08581B7047CA63971B7462AC84E17E6A7B2E48A3CEB62973CED | 48k PCM帧流 |
| task014/rtl/energy_envelope.v | C8745087C2A43D7201E3CBC3578A4CEECA86D97D98648FC138269E32CBDE2A16 | M2 |
| task015/rtl/rgb565_to_rgb888.v | 8FBD6E75200E186E3737E508470947E7D06E348F8AEA6442D2E345D5F4A0AD67 | RGB扩展 |
| task016/rtl/axis_pixel_adapter.v | 309071D0C1151AA10649BA31EB7EE3D9080988C5B8D7E7AB47A4212F5831B20E | AXIS适配 |
| task017/rtl/fake_energy_gen.v | C4ECC8BFBD8D7956A29E74C815BB6C898B66C9227859413667A09F772D986641 | 第一阶段假源 |

Task024输出与017均为`energy_out[63:0]`、lane0低8位；024多PCM输入，48k样本间隔525拍满足TSMIN≥35。024在frame_tick后≤34拍更新，真实视觉集成至少按两帧确定性延迟建黄金。

Task023以太网预研仅“带条件可行”：原型WNS -2.214ns/18违例且未上板，不属于M4依赖。Task029确认字幕需补x计数/RGB888叠加点，双帧转场受单读端口限制。
