KoneFly/eg4s20bg256-media-terminal/visual/eight_bar_renderer/doc/spec/behavior_spec.md

# 八柱渲染行为规格 v0.1

## 功能边界

输入8路无符号能量，输出与外部时序同步的RGB565像素；不生成视频时序、AXIS、音频或存储事务。端口、坐标采样、复位与场提交规则以任务根目录 `INTERFACE_SPEC.md` 为准。

## 像素函数

有效画幅 x∈[0,639]，y∈[0,479]。颜色背景为16'h0000。

对 x∈[64,575]：令 u=x−64，band=u[8:6]，offset=u[5:0]。band=0..7。只有offset<48时可能着色。

height = energy_snapshot[band] >> active_shift，范围0..255。比较前扩展为10位，top=10'd420−height。命中条件是 y≥top 且 y<420。height=0时条件不可满足。其他坐标及消隐均输出背景。

颜色由active_palette与band查下表；非0/1/2的异常palette回退0。比较和加减均用足够位宽的无符号量，禁止8位截断420或有符号比较。

| palette | band0 | band1 | band2 | band3 | band4 | band5 | band6 | band7 |
|---|---|---|---|---|---|---|---|---|
| 0 琥珀 | FEE0 | FDC0 | FCA0 | FB80 | FA60 | F940 | E820 | D000 |
| 1 苔绿 | BFF7 | 9FF0 | 7FE8 | 5FE0 | 3FD8 | 2ED0 | 1DC8 | 0CC0 |
| 2 素白 | FFFF | FFFF | FFFF | FFFF | FFFF | FFFF | FFFF | FFFF |

槽宽64可用位选代替除法，每槽柱宽48留下16像素间隔。八槽占512像素，起点64给出居中观察区域。底端420（开区间）在480行中保留60行底部留白。最大255高无需比例乘法，顶端为165。

## 流水线与状态

不设像素流水线：坐标寄存器→槽位/能量选择→高度比较→常量配色→组合输出，固定0拍。每个有效时隙采样一个像素。能量和参数只在场提交更新，pending参数接受逐拍事件。

模块的运行状态只有复位、等待VS、正常帧观察；计数饱和抑制越界着色，下一VS低清零坐标。坐标、状态与配置的优先级：复位最高，VS处理优先于DE计数，配置提交与按键按接口定义分别更新。

## 假能量源（原型/未来集成的测试定义）

不属于本模块输出或新增端口。帧计数f为9位，每次场提交递增，模512。各通道相位p_i=(f+(i<<5)) & 511；若p_i<256，E_i=p_i，否则E_i=511−p_i。初始f=0，对应[0,32,64,96,128,160,192,224]。每次提交使用旧f产生的向量后再递增；周期512帧，两端平台各2帧，完全由计数和减法实现。

原型提供手动全零、全满、边界阶梯、逐帧与暂停。硬件假数据发生器和按键映射由后续集成任务实现，不将浏览器控件误认为已经存在的硬件功能。

## 验证与资源

固定几何向量见 `../../reference/eight_bars_geometry.json`，黄金表中上下边界均含端点。验证须用固定矩形填充或逐项边界常数；禁止从DUT坐标或公式生成期望。

资源目标：LUT≤600、寄存器估算≤130、DSP=0、ERAM=0、SDRAM访问=0。LUT600是本任务估算目标，超过需解释并重新评估；视觉子系统硬预算LUT≤4000、DSP≤10、ERAM≤12。25.2MHz无负余量才允许进入集成；不通过宽泛时序例外掩盖问题。
