KoneFly/eg4s20bg256-media-terminal/visual/m6_full_display_integration/doc/output/M1R_REPORT_20261006.md

# M1R刷新计数饱和误报修复（2026-10-06）

状态：软件及原生TD通过，修订位真板待测。旧M1封存及报告不覆盖。

旧M1 BDDEBAE7真实板测：d0=5466、d1=255、d2=43528、d3=0、d4=4、d5=1、d6=0、d7=65280；P1=16640、P2=128、P3=65535、P4=16639，彩条正常。0xAA08表示请求方HOLD(5)、引擎IDLE(10)、错误码8；首通过已完成，128次写及16640个正确读字，未见数据不匹配。当前错误来自新增自检判据，不能判成SDRAM硬件或TF错误，也不能签完整FDI通过。

根因：refreshes为饱和16位诊断计数，到65535后不再增长。旧HOLD以refreshes==refresh_base作为缺少刷新判据，约1秒后必然误报。旧11项回归最长约20ms，漏掉该边界，这是本轮修正的验证缺口。

单点修复：计数仍饱和，不回绕；新增1位refresh_seen_in_hold，进入每个保持窗口清零，窗口内收到真实refresh_ack置1；窗口结束以该位或当拍ack判断刷新活性。删除无用refresh_base。冻结SDRAM命令引擎、刷新定时器、50MHz/180°时钟、DQ捕获、SPI及其他功能均未改；顶层仅另设版本05467。没有绕过刷新或关闭错误8。

旧代码边界注入65534后，由真实原引擎ack推进到65535，模型精确复现flags=255/code=43528/address=040000。修复代码在饱和后继续巡检而无误报；随后真正屏蔽保持窗口ack，仍正确报8。原11项功能/故障、实际顶层16页映射回归全部通过，实际开启--assert，编译输入及SOURCE.sha256绑定最终源。边界注入缩短仿真时间，不宣称真实≥1秒或≥10分钟硬件验收。

原生TD最终：938/4900 MSlice，2856 LUT、2520 REG、10×9K/0×32K、0 DSP/3 PLL；Setup +3.500ns、Hold +0.006ns，0/0违例，最终告警0条。9个首级查询及219个动态结果MC4/3精确审计通过，别名OPEN=0；另外9个地址位原生buf证明恒零。原生计数58位、参考LOGIC锥29位、321位M1快照寄存器及32位DQ I/O捕获核验通过。布局阶段违例/别名过程告警原文保留；物理映射器仅补充真实非转义二位总线Q语法解析，未扩大约束范围。route_m1r首次准备在映射完成前退出，未启动TD；成功阶段route_m1r_final/bit_m1r_final。

应用lint 179条告警OPEN、0错误；新请求方/捕获模块默认严格lint各0/0。旧M1的403项封存、板测补充及81项保护资产校验一致。完整M6-FDI启动故障根因仍待分层恢复定位。

主板烧 **M6_FDI_M1R_20261006_685BC8D3.bit**（629643B），SHA256：`685bc8d3f94658f30817e5696930cf9bbfd69506cbdcdbaaea4719f44d4f95ce`。副板7175ECC3及TF卡布局不变，HDMI-B。

复位KEY1（本板丝印KEY2）约1秒后放开，等2秒，SW0=1，每页等0.3秒读取：**d0=05467，d1=00127，d2=00000，d3=00255，d4=00024，d5=d6=23130，d7=65280**。SW0=0：P1=256、P2=128、P3首次通过时刷新数（模型513，要求有刷新）、P4=16639、P5=P6=50597。以上为冻结首通过结果，持续巡检计数不在正常P页实时更新。

请先确认2秒读数及彩条，再持续≥10分钟复读d1/d2/P4并记录彩条，最后KEY1复位复现。异常就保持运行并记录全页；不代签板测。本位通过后进入原TF读链。板测状态PENDING_M1R_BOARD_TEST，未自动烧录、未写BURN_INDEX。
