KoneFly/eg4s20bg256-media-terminal/visual/m6_full_display_integration/doc/output/M6_FDI_DESIGN_REVIEW.md

# M6-FDI 一页方案评审

日期：2026-10-04｜评审已确认并实施；**后续固定RTL物理探测MSlice5099>4900，当前HOLD**，见[实测报告](M6_FDI_INTEGRATION_REPORT.md)。以下为原确认方案，90%实测门禁不变。基座052第四步 `75959E68B425DE7A`，副板 `7175ECC3` 不变；范围为完整标签链、W2、T1/T2、S2及底部128柱。

**载入路径与选择。** 采用 TF→FAT32 根目录 `PCB.BMP`→固定640×480 BMP24纯截断→片上SDRAM。任务副本仅保留一个文件检索、卡协议/FAT簇链、BMP严格格式检查及固定地址递增；保留已验SDRAM命令/刷新/DQ预捕获，裁去图片多槽管理、重采样、转场、音频及全功能帧缓冲管理。这是启动包允许的窄路径适配；不改黄金、052通信应用层或043主线。资产勘误：文件实际 **24bit、921654B（头54B）**，614400B为转换后的16bit标签数据，文件CRC32 `47E2A01D`，正向标签小端CRC32 `9E9CE1C5`。启动写入及全量读回校验通过后才使能标签；失败锁存LED故障并以数码管明确区分卡/文件、格式、校验、读供给错误。

**全资源预算（器件为EG4S20BG256，采用TD `#lut`口径）。** 下表是设计分配，**不是合体实测或门禁PASS**；“替换底数”按移除当前简化S2并加入完整S2+W2推算，保留扫描/通信及其余既有件，新增额度包含T1/T2、加载、行缓存、FIFO、CDC、CRC和诊断。

| 资源 | 基座实测 | 替换底数¹ | 新增分配上限² | 总目标 | 器件容量 / 90%整数上限 |
|---|---:|---:|---:|---:|---:|
| LUT | 8633 | 14436 | 3100 | 17536（89.47%） | 19600 / 17640 |
| REG | 6419 | 8154 | 4000 | 12154（62.01%） | 19600 / 17640 |
| ERAM9K | 25 | 31 | 20 | 51（79.69%） | 64 / 57 |
| ERAM32K | 1 | 2 | 8 | 10（62.50%） | 16 / 14 |
| DSP | 4 | 20 | 6 | 26（89.66%） | 29 / 26 |
| PLL | 3 | 3 | 0 | 3（75%） | 4 / 3 |

¹ 完整S2独立 `#lut=2228`/REG600/9K8/DSP19，W2为4492/1544/32K1/DSP1；扣旧S2层次917 LUT/409 seq/2 BRAM9K/4 DSP。REG层次口径与总统计可能存在边界差异，须以合体TD替换此投影。² 各资源分配不是已实现节省。现成TF文件链参考2942 LUT/4 DSP，加非重采样BMP/SDRAM参考2014 LUT/6 DSP，直接拼接投影 **19392 LUT（98.94%）、30 DSP（器件仅29）**，尚未计新增标签行链，故不放行该候选。新增窄链须相对此参考裁减并覆盖全部胶水，整体实测任一项超过90%即停待裁，不删效果或自行放宽门禁。

**引脚与时钟。** SDRAM用片上 `EG_PHY_SDRAM_2M_32`，无新增外部SDRAM脚。TF四脚 `A14/B14/A13/A12` 全部LVCMOS33，与基座46项显式约束及HDMI自动负端交集0；保留已验HDMI映射，预计54/188 pad。官方lab_ex_6证明TF+SDRAM+HDMI共存，lab_ex_4另证TF+SDRAM+Ethernet，不能把lab6称为含网口或照抄其旧HDMI脚。为避免第四PLL，拟仅将现网络PLL**未使用的C1/C3**设为50MHz 0°/180°（DIV20、CPHASE19/9），保留VCO/反馈、C0/C2/C4和HDMI PLL/PHY参数；任务副本显式导出新时钟，生成约束、DQ双相时序及原网口回归均重新核验，当前未测。

**行读取、扫描与W2衔接。** 标签保留槽0尾部32bit字址 `0x40000+(479-y)×320+(x>>1)`；逐行ROM按 `[31:22]x0/[21:12]x1/[9:0]n` 解码，n为连续区段宽，区段内零标签保留，区段外及y≥451补零。480行核对0失配，最大513半字；单项行缓存容量≥640半字，按BL8边界取数（前451行共93456字、最宽264字/行，**不是耗时实测**）。刷新硬优先；启动期写入/校验，运行期标签行填充优先于诊断，不边显边写；按行消费握手防覆盖。`async_pixel_fifo`为1024×32、AFULL_MARGIN36，`{label,image=0}`同拍写入，严格按已验寄存读语义消费；沿用S2648有效拍延迟/帧尾flush与基座双行重定时，不改变HDMI扫描/AXIS。快照仍用原三银行/epoch/500ms离线机制；消隐收齐128字节并握手到50MHz W2，保持T1 512写→T2 140写→DRAIN→commit/done，写口同时驱动真双口表和S2 barcache，消费侧确认commit后回ack。整批写须在消隐窗口完成，首批状态及标签就绪才开放S2；静音按冻结黄金衰减至零，不新增epoch复位语义。

**确认后执行及放行。** 在任务副本落实裁剪/时钟适配、核定整体TD预算，完成集成台（冻结W2写口黄金、表读写、307200像素/标签顺序、故障与epoch），全工程Setup/Hold端点违例0、覆盖/CDC例外审查、告警逐项OPEN。交付逐文件diff、证据、候选bit；BURN_INDEX登记与验收签字由主人/规格方处理；配合上板核验完整线稿、动态、底部128柱及≥10分钟稳定。此为原放行计划，当前实测已触发停止，未出bit/上板。

证据与复跑：[PREFLIGHT.json](PREFLIGHT.json)、[详细核查](M6_FDI_PREFLIGHT_NOTES.md)；`node "rtl_handoff/m6_full_display_integration/scripts/preflight.cjs"`。**确认记录：用户回复“确认按裁剪方案实施（推荐）”，授权上述固定文件/尺寸裁剪、C1/C3时钟适配；90%实测停止规则继续执行。**
