KoneFly/eg4s20bg256-media-terminal/visual/m6_full_display_integration/doc/output/TF1_REPORT_20261006.md

# TF1：独立基准时钟TF首扇区自检（2026-10-06）

状态：M1R已完成用户确认的≥10分钟及复位复现；TF1软件、布局布线、精确CDC范围及原生连接通过，新位待真卡板测。完整M6-FDI仍未验收。

主板位：**M6_FDI_TF1_20261006_9345F2B7.bit**（629643B）；SHA256：`9345f2b77237f0a42ac1676bae3822f739455795afae94e847c3e057c8c46203`。副板保持7175ECC3，HDMI-B，使用既有受控TF卡，不改写卡内容。BURN_INDEX由主人/规格方登记，本工具不烧录。

变化仅在新增TF请求/诊断层和顶层页选择：原SPI六模块逐字复制，初始化2048轮/分频63、扇区读分频1保持，初始化390.625kHz、读取25MHz；在独立clk_50 BASE域、KEY1复位下运行，不依赖原CTRL复位/加载启动。MISO零人工EG_LOGIC_BUF；原S1、M1R控制器、SDRAM命令/刷新引擎及50MHz/180°时钟逐字不变。既有数字页改显示TF状态，P4/P5/P6继续暴露S1/M1R健康。遵循KISS，未添加文件系统或新的SPI实现；冻结驱动以接口复用。

每次CMD17只读LBA64，要求512字节索引连续、原读引擎CRC16无错、整扇区CRC32=F4505F24。成功后每约250ms复读，P1成功次数递增、饱和65535；CRC32逐位计算共享异或网络。成功读数只在完整通过时更新，首次失败覆盖为首错并冻结，卡引脚CS高/SCK低/MOSI高。初始化及扇区读取各有外部10秒超时，START等待忙状态也有超时。无失败自动重试/擦除锁存。

这不是完整文件双CRC通过：921654B BMP文件CRC32=47E2A01D、解码后SDRAM标签CRC32=A1E4D4E1仍留下一步。原初始化器固定假设SDHC，未新增OCR/CCS识别，沿用受控卡契约；不把模型OCR应答当实际识别证据。TF区64..1864，PCM从2048起，诊断不访问PCM。

TD最终：**1123/4900 MSlice、3635 LUT、2932 REG、10×9K/0×32K、0 DSP/3 PLL**；Setup **+3.180ns**、Hold **+0.003ns**，**0/0**。保留全部阶段原文，路由阶段RUN-6004单端网告警1条OPEN；出位阶段0新增告警，不据此抹去路由告警。物理容量余量3777 MSlice。

CDC：9个逻辑首级D映射为10个物理精确引脚，其中7个实际时序首级端点、3个PLL硬宏输入查询（两个逻辑PLL源）；219个动态冻结数据D端MC4/3，229个精确查询，源域D/CE误豁免=0、像素误豁免=0、别名OPEN=0。无新增TF CDC。TF全部455位原生寄存器均核验BASE钟域及实际物理Q连接，四个TF引脚B14/A14/A13/A12与原ADC一致；MISO无false-path，输入max10/min0、输出max2/min0为沿用设计预算，未测真卡/板级延迟。

原生S1计数58位、独立参考29个LOGIC锥、M1R快照321位、32位DQ I/O捕获继续核验。审计器补充FX数据锥：依据本机安路EG_PHY_MSLICE specify，包含两组a..d及本路mi，所有依赖保持LOGIC；排除门级/物理之间不具有身份的open_n编号作为网络别名。没有RTL修补、没有扩大例外范围；place和route生成的physical.sdc SHA一致。主板真实时钟绝对频率、真卡I/O延迟及加密HDMI内部行为仍由上板约束验证。

Verilator --assert：实际SPI针脚假卡8项（正常复读及复位、无卡、数据CRC错、扇区内容错、初始化静默、读取静默、首通过后的CRC错、字节乱序）全部通过；故障回归缩短计时与轮询，SPI分频保持。另以交付默认全部参数跑正常复读及复位通过（仿真507ms），不代签10分钟硬件运行。实际顶层16页、完整CRC32高低半字及M1/S1故障显示通过。新包装默认严格lint 0/0，应用-Wall lint 186告警OPEN/0错误，既有假卡模型的编译告警OPEN。模型与编译输入SHA绑定，不用HDMI/PLL替身证明硬件功能。

历史M1R284项、初读2项、长稳3项及81项受保护资产校验通过；全部复用驱动/自检源逐字SHA核对。旧位与旧证据不改写。

## 真卡操作与读数

插入原受控TF卡，将本位烧到主板。复位按键约1秒（RTL KEY1，本板丝印KEY2），放开等12秒。彩条应一直正常；SW0=1，每页等0.3秒：

| 页 | 预期十进制 | 含义 |
|---|---:|---|
| d0 | 05468 | TF1版本 |
| d1 | 00127 | 初始化、读请求、512B、CRC及成功七项通过 |
| d2 | 00000 | 首错码；非零保持运行并记录全部页 |
| d3 | 00512 | 完整扇区字节数 |
| d4 | 00112 | 初始化原内部debug，完成静止值 |
| d5 | 24356 | 首扇区CRC32低16位5F24 |
| d6 | 62544 | 首扇区CRC32高16位F450 |
| d7 | 65280 | 固定校验页FF00 |

SW0=0：P1成功次数约4次/秒递增；P2=0（初始化/读R1均0）、P3=112（锁存请求WAIT_READ=3/reader IDLE=16）、P4=16639（S1健康）、P5=127/P6=0（M1R通过/无错），P0/P7同版本/校验页。十秒外部watchdog按BASE时钟设计，等12秒保证初始化或读取静默也会有结果。P1连续读两次、间隔2秒，应明显增加。

错误码d2：17/18/19为原初始化错误1/2/3；33..38为原reader错误1..6（37=数据CRC16）；224=等初始化忙超时、225=初始化静默超时、226=等reader空闲超时、227=读取静默超时、228=字节次序、229=字节数或CRC未完成、230=CRC计算重叠、231=首扇区CRC32/受控素材不符、239=包装非法态。d1位7置位，d4为原init debug；P3高3位为包装锁存态、低5位为reader态，P2保留两种R1。首次成功后的故障d1=255，以首错为准。

先反馈初始d0～d7及P1两次/P4～P6和彩条；异常不再复位。初读通过后持续≥10分钟，确认P1增长、d1/d2及P4/P5/P6无故障，最后复位重复读数。真卡通过才进入完整受控加载及双CRC，之后恢复完整效果。本独立BASE域成功不能单独证明原A4失败源于MISO或CTRL依赖。
