KoneFly/eg4s20bg256-media-terminal/DELIVERY_INDEX.md

# 归档交付索引

最后核对日期：**2026-11-04** | 维护者：浮浮酱

本仓库保存**基线代码**与**有重大改动的版本代码**（改动前后各一份作版本迭代）。它不镜像活动工作区，也不代表所有功能现状。

> **政策更新（2026-10-14）**：纳入范围由「只收上板 PASS 的归档」**扩为「基线 + 重大迭代版本」**；**重大迭代即使未出 bit，也以纯代码快照纳入**（须标注状态）。**项目级文档不纳入**（本地维护）。

## 快照

| 快照 | Bit SHA256 前 16 | 状态 | 上板证据 |
|---|---|---|---|
| task_032_audio_integration | cd4e6d4bb694e2ce | 上板 PASS | 音频集成闭环，后被 037 取代 |
| task_037_board_rework | f4caec0bf445af74 | 上板 PASS | 无声修复、图墙/二级/字幕、轮播无漂移 |
| task_043 步① | 2b7390193d3c1220 | 上板 PASS | 参数调节与供数基础 |
| task_044 批A | 866519aab8aefbff | 上板 PASS | O-1 / O-3 等价优化 |
| **task_043 W7 主线（冻结基底）** | **467a01bc9d52977f** | **上板 PASS（2026-10-06）** | W1–W7 + 转场 P 系列全接线；含 046 加载提速、字幕线（仪表盘/滚动说明条/LRC）、参数调节 |
| **073 最终提交版（主板 F3.5 / 副板 R69）** | **250e679b…cc4661 / 55d30f56…991d4a** | **已板测（比赛提交版）** | 双板完整工具链；主 PLB 2390、副 PLB 2431；零违例。**不含厂商加密 IP** |

每个快照包含当时的 RTL、约束、对应 bit 与最终 TD 报告（**无 bit 的迭代快照会明确标注**）。task_032 原始 source_manifest 的 51 项均已与本地源码、约束和 bit 核对一致；`SHA256SUMS.txt` 校验复制后的内容。加密厂商 HDMI IP 源文件不纳入，构建需本机安路工具链与合法 IP 文件。

## 待纳入（待确认）

（2026-11-04：原列出的 stage12 整机候选已由后续各代取代，最终版见 073。）

| 候选 | 性质 | 说明 |
|---|---|---|
| **stage12 整机候选** | **重大迭代 · 未出 bit** | 相对 467A 的重大改动：去歌词 + 直角旋转 + 默认图铺满 + 三模式键表 + 两层仪表盘 + 按需图墙 + 八图驻留 + TF 热重载 + 手动播放 |

## visual/（旧方向归档，2026-10-11 已转向）

`visual/` 保存早期「视觉增强」方向的 13 个渲染器原型源码（color_glow / eight_bar / energy_envelope /
particle_terrain / pcb_* / spectral_ridge / tidal_particles / vanta_wave_field）与 m6 全屏集成的
RTL 与文档。**该方向已在 2026-10-11 停止**，代码仅作过程留档；实验副本与门级网表未纳入。

## 不纳入

- task_026：虽有上板 PASS，但归档未能把 bit 与源码快照逐文件绑定；
- task_046：仅有定性观感反馈、未关联 bit SHA，其 B3 TD 记录含 hold 违例（功能已并入 W7 主线快照）；
- task_051：已停止；task_052：链路已收官，按主人指示未纳入；
- **副板 bit `F77781CDA45F36CD`**：⚠️ 只有「独立模式灯态观察 PASS」，且记录「**板上频谱数值及双板数据面仍未验**」⇒ **不构成数值正确的上板 PASS**，封存待发布，本轮不纳入；
- **stage7–13 各轮**：未出 bit / 未上板（只有「重大迭代版本」才以纯代码快照纳入，见上表）；
- 官方 / 开源资料、个人素材、测试黄金大文件、临时编译输出、过程文件、失败 bit 均不纳入；**项目级文档亦不纳入**（本地维护）。

审核范围仅为本仓库文件；本机完整任务工作区在外部保留。`SHA256SUMS.txt` 覆盖除自身外的交付文件。

---

*浮浮酱 ｜ 2026-10-14 ｜ 冻结树一致性核对通过（本地生产树最后改动 2026-10-05，早于 10-06 推送）。*
