KoneFly/eg4s20bg256-media-terminal/visual/pcb_sketch_renderer/MOVED_TO_TASK_045.md

# 已正式立项 → **task_045**

> **2026-09-27**：本任务包已通过**中间检验**（验收方自查 24/24），
> 并按 `visual_workspace/HANDOFF_WORKFLOW.md` **第 ⑤ 步「正式立项」**，移交并编号为：
>
> ## ➡️ `iccoder_workspace/tasks/task_045_pcb_pixel_renderer/`

## 本目录的定位

**视觉线留存的签发存档**（供追溯），**不再是工作副本**——
**实现方在 `task_045` 工作区开工**，本目录后续不再同步。

## 中间检验记录（验收方，2026-09-27）

| 检查项 | 结果 |
|---|---|
| 四份核心文档齐备 | ✅ `TASK_BRIEF` / `INTERFACE_SPEC` / `VERIFICATION_CONTRACT` / `START_PROMPT` |
| 六维设计审查完整性 | ✅ 六维均给具体内容（资源栏含 LUT/ERAM/DSP 数字，无"不适用"空栏） |
| IP 复用评估 | ✅ 已查 TD IP 库（RAM/ROM/Divider/CORDIC/FFT/VideoNPU），结论"不引入需仿真的厂商 IP" |
| 硬件约束表 | ✅ 含时钟域（25.2MHz 像素域 + 50MHz 写侧）、片上 vs 外部、无引脚约束 |
| 调试与可观测性 | ✅ 失败分支表 + 探针建议 + sticky 失败码（超时/失配分开） |
| 接口真冻结 | ✅ 完整 Verilog 声明 + 冻结声明 + **状态表内存图冻结**（与 S3 双向契约） |
| 验证契约可执行性 | ✅ 9 场景均有刺激与可观察检查项；协议检查 4 项 |
| **黄金数据独立性**（LESSON-001） | ✅ 由 `reference/gen_vectors.cjs` 从 JS 参考模型独立生成；`UPSTREAM_FACTS.md §5` 显式声明不得改黄金 |
| **数学可实现性** | ✅ 新增《算术实现清单》：逐一列出乘除及其精确实现；**`/3`、`/90` 两个除法的魔数已全输入域穷举验证**（`0xAAAB>>17`、`0x2D83>>20`，0 失配） |
| 边界与规模覆盖 | ✅ 全帧 307,200 像素 × 9 场景 = 276 万像素逐位；saturate/all_zero 覆盖上下界 |
| 规范必填章节 | ✅ `边界与规模覆盖` / `分层与时间预算` / `提速措施` / `时序要求` 齐备，标题与 `WORKSPACE_TEMPLATE` 逐字一致 |
| 资源预算 | ✅ 估算 ≤5 ERAM / ~1200 LUT / ≤5 DSP，在视觉预算（4000 LUT / 12 ERAM / 10 DSP）内 |

**自查结论**：24/24 通过，未触发打回项。

## 交付给实现方的关键提醒（摘自 START_PROMPT）

1. **状态表内存图是冻结契约** —— 与 S3 `pcb_frame_updater` 双向绑定，不得自行调整；
2. **不要实现音柱粒子与柱顶连线** —— 归 S2b；黄金已把它们置零，自己实现会导致逐位比对失败；
3. **除法不得近似** —— `/3`、`/90` 的魔数已给且已验证；
4. **不得反推黄金** —— 发现不一致要停下报告。

## 后续

- **实现方**（国模）→ 在 `task_045` 开工（本包 `doc/brief/START_PROMPT.md` 即启动提示词）；
- **验收方**（浮浮酱）→ 按 `iccoder_workspace/ACCEPTANCE_SOP.md` 做结果验收（第 ⑦ 步）；
- **视觉线** → 交付后由浮浮酱接入 S6b 主线集成包。
