KoneFly/eg4s20bg256-media-terminal/visual/color_glow_renderer/reference/FRAME_EVENT_VECTORS.md

# M3 固定帧事件向量

所有子场景独立复位。frame_phase复位511，所以F0为首次完成VS定位并提交后的phase0完整有效帧；能量均为255、shift=0，除非另写。公开像素锚使用band0：亮顶`Pcap=(76,165)`，核心纹理`Pcore=(76,250)`，近光顶部`PnearTop=(73,162)`，近光侧面`PnearSide=(73,250)`，远光顶部`PfarTop=(70,158)`。帧事件在有效区发生时，下一次frame_commit提交；与frame_commit同沿时提交旧pending。

## A. 主题循环（CG07）

| 帧 | 前序事件 | active_theme | Pcap固定期望 |
|---|---|---:|---|
| F0 | 复位默认 | 0 | 3FFF |
| F1 | F0有效区KEY0 | 1 | 3BFF |
| F2 | F1有效区KEY0 | 2 | 7DF7 |
| F3 | F2有效区KEY0 | 0 | 3FFF |

每帧另对24个固定核心色表锚逐项检查；Pcap不能替代完整色表。

## B. 光晕循环（CG08）

默认active_glow=2。每次KEY3在有效区打一拍：

| 帧 | active_glow | PnearTop | PnearSide | PfarTop |
|---|---:|---|---|---|
| F0 | 2 | 134C | 134C | 背景0022 |
| F1 | 3 | 134C | 134C | 09A6 |
| F2 | 0 | 背景0022 | 背景0022 | 背景0022 |
| F3 | 1 | 134C | 背景0022 | 背景0022 |
| F4 | 2 | 134C | 134C | 背景0022 |

核心栅格、渐变和亮点在四档中完全相同；只比较外部壳层差异。

## C. 冻结与解冻（CG09）

F0提交能量128（top292），并在F0有效区KEY1；F1输入255、F2输入32，画面边界仍top292。F2有效区再次KEY1，F3提交输入32，边界变top388。frame_phase仍每帧推进，因此冻结只保持几何高度，纹理亮点仍可移动；TB不得要求冻结画面逐像素完全相同。

固定几何锚：F0–F2 `(76,291)=近光色或背景（由glow层）`、`(76,292)=亮顶色`；F3 `(76,387)=近光色`、`(76,388)=亮顶色`。最终应按固定全帧模型检查。

## D. 组合键与KEY2优先（CG10）

F0有效区KEY0+KEY1+KEY3同拍：F1 active_theme=1、freeze=1、glow=3，能量快照保持F0。F1有效区KEY0+KEY1+KEY2+KEY3同拍并把输入改64：KEY2覆盖，F2 active_theme=0、freeze=0、glow=2并采入64（top356）。必须由颜色、外光和边界三类公开像素共同证明。

## E. 提交边沿（CG11）

三个独立子场景，初始theme0：KEY0在提交C前1拍→F1 theme1；与C同沿→F1 theme0、F2 theme1；C后1拍→F1 theme0、F2 theme1。KEY3和KEY1分别重复同类边沿覆盖。所有事件满足建立/保持，不能在采样沿临时赋值。

## F. 帧相位与纹理亮点（CG16）

固定能量255/theme0/glow0。frame_phase在每次commit加1，整帧稳定。固定坐标`(76,250)`在phase 16、18、19、20、21、22、23输出亮顶色3FFF，其余phase 0..31输出核心色2EB9；这是预先冻结的32帧亮灭表，TB不得在运行时复写hash。栅格间隔坐标`(82,250)`在所有phase恒为背景0022。

本文定义控制时序，不构成RTL仿真证据。实现方若发现某个纹理锚的预计算值与JSON全帧黄金冲突，先报告，由规格方修订统一来源，不能自行选择有利版本。
