KoneFly/eg4s20bg256-media-terminal/visual/color_glow_renderer/reference/UPSTREAM_FACTS.md

# M3 上游事实快照（2026-09-15）

| 文件 | SHA256 | 事实 |
|---|---|---|
| task020/rtl/eight_bar_renderer.v | FE782BCA951FB58412F2A18829F20954CD7C609FFA84DA7BA64ECD60753D2CCA | 集成相位修订版，上板8柱通过 |
| task014/rtl/energy_envelope.v | C8745087C2A43D7201E3CBC3578A4CEECA86D97D98648FC138269E32CBDE2A16 | 64位包络，M2 |
| task015/rtl/rgb565_to_rgb888.v | 8FBD6E75200E186E3737E508470947E7D06E348F8AEA6442D2E345D5F4A0AD67 | RGB565位扩展 |
| task016/rtl/axis_pixel_adapter.v | 309071D0C1151AA10649BA31EB7EE3D9080988C5B8D7E7AB47A4212F5831B20E | 组合AXIS适配 |
| task017/rtl/fake_energy_gen.v | C4ECC8BFBD8D7956A29E74C815BB6C898B66C9227859413667A09F772D986641 | P128假能量源 |
| task020/constraints/visual_hdmi_top.adc | 35710A12A9721B45D9F591371E97F48CE25C9B6B54EE794C34C5FB8C2A931395 | 修复后ADC，D2=E1/D1=F1/DDC上拉 |

Task020验收证据：仿真26/26、TD 0违例，返工bit SHA256 BD2E5A1AA2072A6151516228B8D9B670E409363D9403A61E31855D1C4CE18803，2026-09-15上板显示8柱波浪。视觉链五模块实测830 LUT/240 REG/0 DSP/0 BRAM；全片资源另含HDMI加密IP。

板卡除A2复位外另有B2/C1按键，但Task020顶层未接入并将key/sw固定0。M3默认theme0/glow2，固定0仍可见；物理键分配留给集成任务。
