KoneFly/eg4s20bg256-media-terminal/visual/m6_full_display_integration/doc/brief/BOARD_DIAGNOSTIC_ISOLATION_PLAN_20261006.md

# M6-FDI 分层板测计划（2026-10-06）

当前卡点：A4观测store BOOT0、SD init IDLE0、reader IDLE16、eng_init0，尚未见标签加载启动。d2历史bit27已见1却未见bit16，不能按正常从零+1计数解释。d3持续变化证明有计数活动，不证明50MHz正确。HDMI明确无信号，但有效视频DE受加载就绪门控，可能是同一启动停滞的下游结果。

选择：暂停完整工程中连续叠加观测，改为已验位对照、最小自检、逐层接回。完整功能和冻结语义仍是最终目标；诊断工程单独命名、单独出位、不得登记为功能修复或验收通过。

## 第一步：现成已验主板位对照

- 文件：`D:/Download/嵌赛fpga_安路/eg4s20bg256/topic1_media_terminal/iccoder_workspace/tasks/task_052_ethernet_pcm_link/td_run/v9_display_20261004_final2/eth_udp_m6_master_top.bit`。
- SHA256：`75959e68b425de7a36ee937949c683b956d90164ea72c68e2bbcd40b6d5d5d1b`，本轮现场哈希一致。
- 依据：052 `doc/output/STEP4_M6_DISPLAY_20261004.txt`末尾记录2026-10-04用户总体验收通过；不据此虚构逐项板测数据。
- 主板做一次临时对照；副板仍7175ECC3，接线和显示器保持本次A4条件，使用主板**HDMI-B**。受控TF不重写；本位不消费标签图TF链。
- 此位的SW0=1恢复旧r诊断页，**不能套用A4的d0/d7语义**。SW0=0为P页，P7=05401、P1期望1；P1为IP输入锁定状态，不等同显示器实测正常。KEY1为RTL端口，板上对应丝印KEY2。
- 核对主板版本P7=05401，KEY1全复位放开后观察640×480黑底及底部128柱；连接副板时进一步观察频谱更新。先确认有信号和图像，再持续10分钟并复位复现，记录P1及屏幕。
- 若仍无信号：先定位当前HDMI-B接线、输入源、烧录校验、板/线/显示器环境，必要时以一次受控换线或换显示器对照；暂停以新FDI RTL解释所有现象。
- 若恢复稳定图像：证明当前环境能运行已验基座显示；进入第二步，不把结果直接签成完整FDI修复。

## 第二步：最小启动自检（待实施，无新bit）

独立任务副本，只保留相同50MHz引脚、原PLL配置/出口及复位、数码管、固定640×480视频源和小型自检逻辑。视频源不得等待label_ready、W2提交、SD或SDRAM就绪，以隔离DE门控与显示物理链。使用已验HDMI包装/IP，不重写厂商IP。

自检以只读方式比较基准域和CTRL域，给出有有效标志的有限窗口进度/频率观测；不能以一个“边沿出现”位签频率正确。覆盖从零计数跨65535→65536、启动等于499999、SDRAM等待门槛9999、复位释放及运行后重现，读数在跨域握手后稳定保存，避免追读快速变化值。实现后先验证测量范围、停钟/错频/复位与计数边界故障注入，再核对原生寄存器/计数连接和精确CDC命中。

若这里失败，故障范围收敛到时钟/复位、计数实现或显示链；仅针对失败点选择一个变量做对照，例如在独立自检中比较同频基准时钟与PLL CTRL出口。这不是提前批准改写完整工程的时钟方案。若通过，再接第三步。

## 第三步：冻结加载链分层恢复

| 层 | 恢复内容 | 板上通过条件 |
|---|---|---|
| SDRAM | 原引擎、原50MHz/180°时钟与参数，独立请求方 | 初始化完成；有限BL8写读一致；刷新和复位后可重复 |
| TF | 原SPI/SD初始化/受控LBA读，卡布局不变 | 初始化完成；固定标签头扇区读出正确，再完成原图加载 |
| 校验 | 原文件CRC与SDRAM读回CRC路径 | 对本包黄金双CRC匹配；无卡/CRC故障有诊断 |
| 完整显示 | 原W2/S2、状态表、行缓存/FIFO及动态效果 | PCB线稿、动态与底部柱完整，≥10分钟稳定，KEY1可复现 |

各层独立日志、bit身份、实际状态、时序/面积和板测结果绑定。若新增一层失败，停在该层做单变量比较，不同时修改多个已验驱动。模型结果不能代替上板。

## 门禁与交付边界

每颗新诊断位仍要求TD Setup/Hold 0/0、精确CDC范围、源哈希和告警如实记录；独立自检余量充足不代表完整集成容量已解决。最后回到完整工程时沿用物理≤4900且正余量、目标≤4850、争取≤4410及既有黄金/冻结语义。修复只改证实的故障点；不删效果凑资源、不修改052/043/副板/W2/S2保护文件、不覆盖封存或代写BURN_INDEX。

若已有示波器/逻辑分析仪，可辅以对有明确测试点的时钟/复位信号测量；未核对引脚前不临时驱动外设线。没有仪器时，上述板内自检足以开展分层定位，不要求购买工具。
