KoneFly/eg4s20bg256-media-terminal/visual/m6_full_display_integration/doc/brief/BOARD_DIAGNOSTIC_PROGRESS_M1_20261006.md

# 分层板测进度补充：S1通过功能检查，M1待上板

2026-10-06，承接封存的 `BOARD_DIAGNOSTIC_ISOLATION_PLAN_20261006.md`。本补充不覆盖历史计划、位文件或证据索引。

- 已验主板参考75959E68：用户报告画面正常、P1=1、一直正常。
- S1独立启动自检4BA41B2F：用户报告“可以正常显示彩条”，随后对d0～d7给定预期回答“全部正确”。记录为用户确认的功能检查通过；没有逐项原始数值、精确持续时间或KEY1重复记录，≥10分钟稳定仍未代签。
- M1独立SDRAM自检BDDEBAE7：模型断言、顶层诊断页和原生TD签核通过，硬件待测。冻结引擎、刷新定时器、原50MHz/180°时钟及DQ_LAT=1，彩条独立运行。
- M1目标：四个bank、行/列边界附近共64字；地址编码及反码两组；128次单字写，32次BL8读共256字验证；两次4ms刷新保持后读回。首次通过后持续每4ms执行64字只读巡检，首错锁存。
- M1板测通过后才恢复原TF初始化/受控LBA头扇区读，再恢复标签全量与黄金双CRC，最后恢复完整W2/S2显示及动态验收。发现失败就保持该颗位和首错，按实际错误阶段选单变量比较。

最终完整M6-FDI仍要求PCB线稿、冻结动态、底部128柱、≥10分钟稳定及复位复现；独立彩条或SDRAM自检不代替完整验收。副板7175ECC3、受控卡布局、052/043、W2/S2及旧位均不修改。未操作BURN_INDEX、未自动烧录。

详细烧录身份、读数和门禁见 `doc/output/M1_SDRAM_SELFTEST_REPORT_20261006.md`。
