KoneFly/eg4s20bg256-media-terminal/visual/m6_full_display_integration/doc/brief/BOARD_DIAGNOSTIC_PROGRESS_M1R_20261006.md

# M1板测与M1R单点修正进度

2026-10-06：M1 BDDEBAE7真板彩条正常、P4=16639，完成128次写及16640字正确读回后，d1=255、d2=43528、P3=65535。已由旧源边界模型精确复现：饱和计数不再增长，误触发“缺少刷新”错误8。此错误来自新增诊断判据；原完整FDI启动停滞根因尚未证明。

M1R只修该判据：保持窗口内锁存真实刷新ack，计数继续饱和显示。冻结SDRAM引擎/刷新定时器、时钟、DQ捕获、SPI、W2/S2、上游与副板未变。补充饱和不误报、真正无ack仍报8两项边界检查，原功能/故障回归继续通过。

M1R版本05467，主板新位见 `doc/output/M1R_REPORT_20261006.md`。软件及原生TD签核通过；真板持续≥10分钟与复位复现待用户确认。旧位、旧报告、M1的403项封存不覆盖，板测另立补充索引。

后续仍按分层计划：M1R真板通过后恢复原TF受控读，再恢复全图与双CRC，最后完整W2/S2显示验收。暂不提前切到TF或改写已验驱动；不代签上板、不自动烧录或修改BURN_INDEX。
