KoneFly/eg4s20bg256-media-terminal/visual/m6_full_display_integration/doc/brief/BOARD_DIAGNOSTIC_PROGRESS_TF1_20261006.md

# TF1分层诊断进度（2026-10-06）

M1R真实板测已通过：用户反馈“≥10分钟均正常，复位后正常复现”，确认彩条、d1=127、d2=0、P4=16639及复位恢复。原M1R软件/初次读数文件不覆盖，新增M1R_STABILITY_BOARD_RESULT及其证据索引。

本步范围是TF初始化和固定LBA64首扇区复读。独立用BASE 50MHz、KEY1复位驱动原SPI模块，绕开原完整加载链对CTRL复位/启动的依赖；保留S1、M1R和彩条。原SPI驱动和SDRAM引擎逐字复用。MISO不插入人工EG_LOGIC_BUF延迟，读分频仍为1（25MHz），初始化分频63（390.625kHz）。这是一条独立诊断分支，不据此归因原A4失败为某一个点。

成功判据：每次CMD17固定LBA64，512字节次序正确、原读引擎CRC16通过、首扇区CRC32=F4505F24。每约250ms重新读一次；成功次数递增，首错锁存并停止卡接口。初始化和读取各有10秒外部超时。未改卡内容，不访问PCM区LBA2048及以后。

TF1不是完整标签图通过证据。首扇区板测及≥10分钟/复位复现通过后，再恢复受控标签图完整加载、文件CRC32=47E2A01D与SDRAM标签CRC32=A1E4D4E1，最后恢复完整显示/动态。完整M6-FDI仍待验收，W2/S2/冻结效果不变，副板7175ECC3不动。

软件模型不替代上板；异常保留本次运行，读取d0～d7和P1～P6，依据锁存错误及初始化/reader内部态定位。位文件、资源、约束审计、告警和烧录步骤见doc/output/TF1_REPORT_20261006.md。BURN_INDEX由主人/规格方登记。
