KoneFly/eg4s20bg256-media-terminal/visual/m6_full_display_integration/doc/brief/BOARD_PROBE_A3_SCOPE_20261006.md

# A3 时钟/启动计数只读排查范围

依据：用户2026-10-06真卡观测——KEY1放开12秒后普通P0～P6全零、P7=05401；SW0=1下d1=4096、d6=0、d7=32512，隔10秒不变。A2硬件FAIL。原话及补充证据见 `doc/output/A2_PROBE_STALLED_CONFIRMED_20261006.json`；不再以R2的10秒60070替代A2现象。

A3是针对持续零进度的只读观测迭代，不是已定位根因的修复位。保持A2功能路径、MISO两级、PLL配置、SPI/SDRAM驱动功能正文、CRC、超时、卡布局、W2/S2与效果。另建 `experiments/board_0x46_A3_work`，不覆盖A2/R2封存、受保护上游或已验位。

新增观测：watchdog原值29bit；SDRAM cnt15bit及eng_init；独立KEY1复位的CTRL心跳16bit；原始PLL锁定/全局reset/CTRL复位同步状态；A2主状态字；固定65280的数码管高位校准。SDRAM等待计数通过只读端口暴露，原时序always块和状态转移逐字节还原核验。

临时UI调整仅在SW0=1：诊断页优先于内部全局reset，允许在PLL未锁/内部复位保持时读标志。数码管自身KEY1复位消隐及SW0=0原显示优先级保留。新观测没有加载控制反馈；全部既有握手冻结。

门禁延续：实际物理MSlice<4900且留正余量（目标≤4850）；最终Setup/Hold 0/0；精确CDC端点、FX两半覆盖审计、ROM INIT、严格加载/W2 lint和应用告警OPEN；11加载用例、2故障快照用例保持原判据。新增探针测试验证复位与停钟区分及原数码管65280转换，模型不代签真卡。

出位后由用户主板实测；副板仍7175ECC3。先检查D0=05463、D7=65280，再观察D4变化及D1/D2/D3/D5/D6，失败也完整回传。若线稿出现，仍需至少10分钟稳定和KEY1复现；单次成功不唯一归因诊断逻辑，物理布局也随新增观测改变。BURN_INDEX由主人/规格方登记，不写受保护上游。
