KoneFly/eg4s20bg256-media-terminal/visual/m6_full_display_integration/doc/brief/ROUND2_SCOPE.md

# M6-FDI 第二轮授权与当前门禁

2026-10-05；依据本轮用户直接授权。原START_PROMPT与首轮报告保留，以下更新优先于原90%停线条件。

- 标签加载改为受控TF固定LBA直读；不再包含通用FAT/MBR/目录/簇链遍历。保留SPI读、扇区CRC16、文件CRC32及SDRAM标签CRC32、无卡/校验失败诊断。
- 标签与PCM素材均由受控TF卡供给，Flash不采用。标签LBA64–1864；PCM FAT32分区从LBA2048起，与052第五步根目录WAV槽格式协调。PC工具和写卡/读回流程属于本包交付。
- 冻结效果、W2、S2不修改；允许不改变RTL语义的综合/物理策略调整。W1、粒子与柱顶连线仍出列；052通信应用、043主线、副板7175ECC3、已验收位保持边界。
- 物理MSlice底线≤4900且有正余量（故实际必须<4900），目标≤4850，争取≤4410。过底线直接继续布局布线和出bit；超4900停报待裁。各其他资源原预算沿用。
- 最终原生TD Setup/Hold均0违例；显式SDC逐目标查询并核对实际例外端点集合，消除像素移位寄存器和源域D/CE别名误豁免。告警如实登记OPEN。
- bit本包归档；外部BURN_INDEX按启动包由主人/规格方走登记流程。实体写卡、烧录和上板验收与主人配合，未验证项不得代签。

当前结果以doc/output/M6_FDI_ROUND2_REPORT.md、ROUND2_MEASURED_GATE.json和ROUND2_EVIDENCE_INDEX.json为准；首轮数字仅为历史。
