KoneFly/eg4s20bg256-media-terminal/visual/m6_full_display_integration/doc/output/A3_PROBE_BOARD_ANALYSIS_CONFIRMED_20261006.md

# A3 真卡校准和BOOT计数复核（2026-10-06）

**A3上板FAIL，无PCB线稿。** 用户确认d0=05463、d7=65280；d6复读为20480，取代此前00270。用户另确认d2=57344一直固定，d1/d4持续快速变化；d3=32768跨10秒不变，d5=270，SW0=0时屏幕无线稿、普通数码管“p均为0”。未逐页确认P7，不把该原话展开成含构建页的八项独立读数。

d6=0x5000：store BOOT0、init IDLE0、reader IDLE16、mem_busy0、eng_init1、init_ready0，与d5一致。d3=0x8000只表示引擎初始化标志1和等待计数0，不能证明SDRAM数据读回通过。d2=0xE000表示KEY1放开、PLL锁定、CTRL复位释放及watchdog高13位0。d1快速滚动而d2不变，将排查收敛至BOOT计数、进位或采样间短暂复位；尚未进入SD初始化，不依据此现象改SPI/CRC或再次换卡。

静态证据 `A3_PROBE_BOOT_COUNTER_STATIC_20261006.json`：门级29个watchdog FF、最终物理29位、8个RIPPLE单元串联，进位连接覆盖16位边界。门级LUT与最终物理LUT INIT展开所得比较条件一致，启动499999、总超时499999999；门级BOOT在65534/65535/65536/499998仍为BOOT，在499999下一拍为INIT；其间计数CE=1、同步清零=0。脚本针对本次实际优化折叠常量/重复输入，并覆盖比较器中的MSLICE FX LUT5，未修改旧A2审计脚本。

这只能排除被裁成16位、比较常量错误等静态问题。原厂RIPPLE模型为加密内容，未做解密，也不把结构连接正确当成板上进位实测；瞬时复位和显示域观测限制仍未排除。

下一轮A4只改临时只读观测模块：按位锁存watchdog“曾经为1”的历史；锁存计数达到499999、离开BOOT、低16位回落事件；由基准50MHz域锁存首次稳定释放后CTRL复位重现/PLL解锁。历史不是数值最大值，低位回落也可能由复位导致，需结合复位事件交叉判断。所有事件仅影响SW0=1页，KEY1清除，功能计数器和所有已验驱动保持原字节。短于基准采样窗口的脉冲仍可能漏采。

旧A3封存330项保持原样；本文件及原始读数作为独立追加证据。没有硬件PASS声明，后续位仍必须真卡复现及≥10分钟稳定验收。
