KoneFly/eg4s20bg256-media-terminal/visual/m6_full_display_integration/doc/output/A3_PROBE_BOARD_ANALYSIS_PARTIAL_20261006.md

# A3 真卡部分读数复核（2026-10-06）

本次记录原文：**d1和d4变化太快了读不出，d2 57344 d3 32768 d5 00270 d6 00270,10秒后还是d3 32768**。

报告出现了持续CTRL心跳和watchdog低位变化，已与A2的持续零进度现象不同。d1/d4当前只需确认在变化，无须人工抄下快速滚动的具体数值。仍需d0/d7确认探针版本与显示校准；本次上板时间、复位经过时间、普通bank、屏幕结果未提供，不沿用A2现象替代。

| 页 | 按A3源代码解码 | 可支持的结论 |
|---|---|---|
| d2=57344 / E000 | key1=1、PLL locked=1、ctrl_rst_n=1、watchdog高13位=0 | 本次采样时锁定且CTRL复位释放；高位0不能单独判断计数复位或时钟频率 |
| d3=32768 / 8000，10秒后仍同值 | eng_init=1、SDRAM cnt=0 | 引擎初始化标志已置位；空闲时计数0可正常，不表示存储数据验证通过 |
| d5=270 / 010E | key1=1、PLL/global reset=0、CTRL同步复位=00、ctrl_rst_n=1、快照reader R1 bit7=1、快照eng_init=1、init_ready=0 | 复位标志相互一致；SD初始化完成标志未置位，尚不能证明其具体等待态 |
| d6=270 / 010E | store=14、init=0、reader=1、mem_busy=0、eng_init=0、init_ready=0 | store14未定义，且eng_init与d5不一致；不能作为有效加载状态解码 |

冻结源定义store为BOOT0至ERROR11，原debug_snapshot逐拍更新并在ERROR后冻结；d6直接显示快照低16位。d5中的eng_init同样来自快照bit14。因此两页读数目前未形成一致状态。可能的页号/显示读回问题与运行时异常尚未区分，不据此盲改状态机或底层驱动。

现有A3软件探针测试已对d5与d6不同输入值分别断言；最终物理审计确认心跳16位的9个寄存器单元均由PLL C1/CTRL GCLK驱动，异步复位来自KEY1 PAD。该静态证据不能替代当前页号、校准值和屏幕的真卡观察。

请保持此次运行，不再复位：确认d0=05463、d7=65280；页110等待1秒，确认实际前缀为d6并复读完整五位数；切SW0=0记录完整普通显示及屏幕。若线稿出现，继续≥10分钟稳定运行及KEY1复现才能验收。

本次仅新增事实记录及分析，没有改RTL、SDC、bit、卡内容或任何受保护上游文件。既有1070项封存证据复核一致；A3既有软件封存PENDING状态作为历史保留，本补充记录不代签上板PASS。
