KoneFly/eg4s20bg256-media-terminal/visual/m6_full_display_integration/doc/output/A4_PROBE_BOARD_ANALYSIS_PARTIAL_20261006.md

# A4 真卡读数复查（2026-10-06，校准与d3细节待补）

本次仍未达到线稿出现与≥10分钟稳定的上板验收条件。用户原话：

> d1 65535 d2 59392 d3一直增加 d4 64 d5 268 d6 4096；十秒后全都一样；切 SW0=0，屏幕无信号，数码管全0

本记录按当前流程预期的A4页定义解码，尚未得到本次d0=05464、d7=65280确认；文件SHA不是板上bit读回。d3“持续增加”与“十秒后全都一样”的关系、显示器明确提示无信号还是黑屏，均保留待确认，不能自行补成确定事实。当前消息也未明确重述KEY1起始操作。

| 读数 | 条件解码 | 对排查的意义 |
|---|---|---|
| d1=65535 / FFFF | watchdog低16位都曾采样为1 | 按位OR历史，不能视为当前计数65535或已饱和 |
| d2=59392 / E800 | KEY1、PLL locked、ctrl_rst_n均1；高13位历史仅0800 | 对应watchdog bit27曾为1，bit16仍未见1；从零正常全宽+1不能形成该历史 |
| d4=64 / 0040 | 仅CTRL边沿标志置位 | 启动等于499999、BOOT退出、bit15回落、复位重现、PLL解锁、非法状态均未被记录；未记录不等于排除 |
| d5=268 / 010C | 复位采样值释放，reader R1最高位1，eng_init0、init_ready0 | 和d6一致，不能沿用A3的eng_init1结论 |
| d6=4096 / 1000 | store BOOT0、SD init IDLE0、reader IDLE16、mem_busy0、eng_init0、init_ready0 | 尚无SD启动/数据读入证据，不能据此归因TF卡、CRC或MISO响应 |
| d3持续增加，无具体值 | SDRAM cnt低15位和eng_init最高位 | 仍需具体值/范围；不能凭文字声称初始化计数已经到达9999 |

已对**A4本身**的原生check_a4门级网表及bit_a4_final物理网表追加只读复查：29个历史寄存器完整，分别保存自身历史OR对应watchdog位，复位均为独立KEY1，时钟均为CTRL；物理OR的其他输入引脚取全部可能值仍满足OR真值。门级d2低13位的26组0/1选通检查通过，确认显示位11对应历史bit27、显示位0对应历史bit16，没有发现这些路径的位序接错。详见 `A4_PROBE_HISTORY_STATIC_20261006.json` 与 `scripts/review_a4_history_readback.py`。本检查没有证明完整物理显示链、实际烧录内容、板上时钟频率或原厂RIPPLE进位传播；旧A3静态审计不能替代A4新增检查。

冻结SDRAM驱动在PWR_UP的cnt==9999处退出等待，随后有限步骤设置init_done；外部SDRAM数据应答不参与这段等待计数。d3若持续变化而eng_init仍0，应优先核对实际计数范围、初始化内部态、共享CTRL时钟/复位；不应改写已验驱动。A4当前d6页不含SDRAM内部态，不能断言它始终停PWR_UP。

下一步先补本次版本校准、d3具体变化与显示器输入状态。若校准成立，安排一次有明确KEY1初始条件的复现，核对异常高位历史是否重新形成。后续诊断应围绕基准域测得的CTRL进度/频率和明确的计数跨界观测；是否出下一版观测位由补读决定。不得直接把“只见bit27不见bit16”认定为进位故障，也不宜仅凭CTRL边沿标志认定50MHz正确。若显示器确实失去输入，同步纳入像素时钟/复位观测，不能把输入丢失记成单纯标签图未加载。

本次只追加观测原文、条件解码和只读静态证据；没有修改RTL、SDC、bit、SPI/SDRAM/校验功能或封存A4报告。副板7175ECC3、受控TF布局及上游文件保持原样。旧A4发布报告的PENDING_TRUE_CARD属于发布时快照，本次硬件FAIL另立补充证据，不覆盖原索引。
