KoneFly/eg4s20bg256-media-terminal/visual/m6_full_display_integration/doc/output/BOARD_PROBE_A2_BOARD_RECORD.md

# A2 真卡观测记录（待主人填写）

状态：**PENDING_TRUE_CARD**。软件/TD/出位已完成；不据模型填硬件 PASS。

主板实验位：`M6_FDI_A2_20261005_7B97635A.bit`。
SHA256：`7b97635aadd6fa4ebab8f3fc598f195cde5bafcdf6b6968bf105ac62284cd57c`。
识别页：SW0=1、P0 → `d0 05462`。普通页 05401 沿用，不能单独区分本实验。

| 项 | 真卡实测 |
|---|---|
| 实测人/时间/主板标识 | 待填 |
| 卡标识（原已独立验证的受控卡） | 待填 |
| 副板及连接 | 待填；原故障记录为 7175ECC3、两板直连 |
| A2 识别页 | 待填 |
| KEY1 复位后的线稿/耗时/错误码 | 待填 |
| 完整环、走线、元件、芯片、音柱 | 待填 |
| 至少10分钟：起止时间、动态运行、撕裂/错位/重启 | 待填 |
| 同位 KEY1 再复现 | 待填 |
| 判定/规格方登记 | 待填 |

若失败，先记录 SW0=0 下的错误码；不复位，SW0=1 切 P1..P7，每页等至少0.3秒，抄末五位十进制。进入 store ERROR 前一拍的快照已锁存。页号 SW[3:1]，SW[3:0] 分别为 3、5、7、9、11、13、15。

| P1 | P2 | P3 | P4 | P5 | P6 | P7 |
|---|---|---|---|---|---|---|
| 待填 | 待填 | 待填 | 待填 | 待填 | 待填 | 待填 |

解码工具：`experiments/board_0x46_A2_work/scripts/decode_probe_pages.py`。未取得真卡记录前不再作功能迭代；本记录不代写 BURN_INDEX。
