KoneFly/eg4s20bg256-media-terminal/visual/m6_full_display_integration/doc/output/BOARD_PROBE_A3_20261006.md

# A3 时钟/启动计数实验位（2026-10-06）

**已生成只读观测位，真卡待实测；未宣称故障修复。** A2 真卡无线稿：普通P0～P6零、P7=05401，诊断BOOT/PWR_UP在12秒后及间隔10秒重读均不前进，未观察到60070。

主板位：[M6_FDI_A3_20261006_C289D59C.bit](D:/Download/嵌赛fpga_安路/eg4s20bg256/topic1_media_terminal/visual_workspace/rtl_handoff/m6_full_display_integration/deliverables/M6_FDI_A3_20261006_C289D59C.bit)，636626 字节，SHA256 `c289d59c93115706b2c996d4a44629d60f70f9809d5f567183228d03bc38c6d9`。副板仍用已验7175ECC3。
实验源/原始TD证据：`experiments/board_0x46_A3_work`；最终原生阶段 `bit_a3_final`。

A3相对A2只有只读观测与临时显示变更：watchdog、SDRAM cnt、原始CTRL心跳、复位/锁定、状态字与65280校准。MISO仍两级，PLL参数/连接、SPI速率/采样、SDRAM时序/握手、CRC、超时、卡布局、W2/S2及效果不变。四个文件的新增观测可逆还原A2；五个驱动功能正文还原原字节；94项源身份守卫、A2封存319项、R2封存400项、81项受保护资产核验通过。源差异保存为隔离版本 `doc/output/SOURCE_DIFF.patch`。

| 实测项 | 结果 |
|---|---|
| 最终物理MSlice | 4652/4900，余 248；达到≤4850目标 |
| 物理LUT / REG | 16206 / 11391 |
| ERAM9K / ERAM32K / DSP / PLL | 43 / 5 / 18 / 3 |
| 最终Setup / Hold | +0.395ns / +0.023ns，违例 0 / 0 |
| 精确CDC | 106物理首级数据端 + 1024多周期数据端；1130查询全部命中；别名OPEN/误豁免0 |
| ROM INIT | 512行通过，不代表bit读回验证 |
| 物理探针 | 16位心跳映射至9个物理单元，时钟逐单元追溯PLL C1/CTRL GCLK，异步复位逐单元追溯KEY1 PAD；不是内部CTRL reset |
| 软件回归 | 11加载用例、2故障快照用例、新增心跳/停钟/65280实际数码管转换测试通过 |
| lint | 加载/W2严格0告警；应用接口0错误/345告警OPEN |

新增应用告警为旧快照未消费位与新probe模块TIMESCALEMOD；诊断TB明确时标。原模型三项哈希一致，未调整SDRAM模型相位。综合初次SDC未正确加载的STA及布局阶段未重映射的别名告警保留为过程证据；最终口径只采用已重载准确物理SDC的原生报告，不用过程结果冒充最终签核。

## 真卡操作

1. 烧本位。SW0=1、页000应见 **d0 05463**；页111应见 **d7 65280**。d7为固定校准值，已经不是卡R1。
2. 按住KEY1约1秒应消隐；放开后保持SW0=1，读d4并观察约2秒，至少抄三次、每次相隔≥0.3秒，判断心跳是否变化。
3. 放开复位12秒后读取d1、d2、d3、d5、d6，再隔10秒重读d1、d3、d4。页切换至少等待0.3秒；记录完整前缀及数字，切页不复位。
4. 切SW0=0，记录普通显示及屏幕。若线稿出现，仍须观察至少10分钟、动态运行及KEY1复现；没有线稿或校准失败也照实回传，不再换卡或盲改驱动。

| 页 | 实时含义 |
|---|---|
| d0 | 固定05463，A3识别 |
| d1 | watchdog低16位 |
| d2 | [12:0] watchdog高13位；[13]ctrl_rst_n；[14]PLL locked；[15]key1 |
| d3 | [14:0]SDRAM cnt；[15]eng_init |
| d4 | 独立KEY1复位的CTRL心跳计数16bit，内部CTRL复位不能清零它 |
| d5 | [0]快照init_ready；[1]快照eng_init；[2]快照reader R1 bit7；[3]ctrl_rst_n；[5:4]ctrl_reset_sync；[6]全局reset；[7]PLL reset(!locked)；[8]key1；高位0 |
| d6 | A2原d1：store/init/reader状态、mem_busy/eng_init/init_ready |
| d7 | 固定65280(FF00)，校准数码管高位 |

watchdog恢复：`((d2 & 8191) << 16) | d1`。SDRAM cnt=`d3 & 32767`。心跳是自由滚动计数，回绕正常；多次变化仅证明持续有CTRL边沿，不能据两次十进制读数精确测频。普通bank无错误码不再作为“卡数据已读对”的证明。

SW0是RTL sw[0]，对应当前ADC的C8（注释板上SW1）；三个页位对应C7/C6/C5。RTL sw[3:0]从d0至d7为0001、0011、0101、0111、1001、1011、1101、1111；0/1指实际电平，不把丝印ON直接当1。

临时SW0=1 bank允许内部reset保持时观察，SW0=0优先级保留。所有观察没有加载控制反馈。若A3成功，新增观测引起物理布局改变，也不能据此唯一归因MISO/PLL；需结合计数和复位读数。真卡未测试，本包不代签硬件验收或上游登记。
