KoneFly/eg4s20bg256-media-terminal/visual/m6_full_display_integration/doc/output/BOARD_RECORD.md

# M6-FDI 上板记录

状态：**NOT_STARTED，资源门禁HOLD，无新bit，无硬件验收。**

2026-10-04 完成当前工程的集成与门级测量，以及用户随后批准的固定RTL物理探测。实际打包MSlice5099>4900，布局未完成，未布线。上游位75959E68、副板7175ECC3未改、未重新烧写。

| 字段 | 当前记录 |
|---|---|
| 待烧主板bit / SHA256 | 无；资源/时序门禁未通过 |
| BURN_INDEX登记 | 未申请，由主人/规格方走流程 |
| 实际板卡/烧录工具/日期 | 未测 |
| 上电静态PCB完整性 | 未测 |
| 静音线稿保持、动态和128柱归零 | 未测 |
| 音柱起伏/峰值帽/走线电流/节点辉光/彗星 | 未测 |
| 底部128柱随频谱更新 | 未测 |
| 副板重启/epoch连续性 | 未测；三银行快照源逐字未改 |
| 无卡/CRC/断供数码管及LED故障码 | 模型已测，板上未测 |
| ≥10分钟连续运行起止时间/异常数 | 未测 |
| 确认人/验收结论 | 留空；不代签 |

恢复实施须先取得超门禁后续裁定、完成资源及Setup/Hold0违例、生成绑定源身份的bit，再配合主人填写真实板测记录。TF仅放固定 `PCB.BMP`（原文件921654字节，SHA256 938219a71dde50745624d8821554cca0822c748149b2e3f9cd8d31eccfe26516）；具体SDHC/FAT32支持边界见LOADER_REUSE_LEDGER。
