KoneFly/eg4s20bg256-media-terminal/visual/m6_full_display_integration/doc/output/GRADED_DELIVERY_FEASIBILITY_20261006.md

# 任务单：B 方案（分级交付）落地可行性评估（2026-10-06）

> 签发：浮浮酱（规格/验收方）｜ 交付对象：执行方
> 依据：主人 2026-10-06 裁定「**B. 分级交付**」
> **本轮只评估、不动手：不改 RTL、不跑综合、不出 bit、不预记节省。**

---

## 1. 目标形态（主人已定）

| 位 | 角色 | 内容 |
|---|---|---|
| **位 1 = 主线 043** | **拿分主位** | 完整多媒体终端（图片/音频/字幕/仪表盘/歌词/转场/参数调节）**+ 频谱可视化** ⇒ **扩展项 ①②③④⑤ 全落在同一位上，且满足赛题基础要求** |
| **位 2 = 独立演示位** | 加分展示 | PCB 线稿全套（label_store / label_stream / W2 / S2）；**待 M6 侧 0x46 修复后** |

**核心诉求**：让「扩展项⑤ 音频可视化」从"专门演示位（黑底彩柱）"**升到主线位上**——因为现状下评委看到的 ⑤ 不是一个多媒体终端。

---

## 2. 浮浮酱已查明的三个阻塞（评估须逐一正面回答）

### Q1 ★ 频谱数据从哪来？（**最根本**）

**事实**：频谱由副板 FFT（`7175ECC3`）计算。副板经**以太网 UDP** 回传（`292B/type2`）。而 **043 主线完全没有以太网栈**（无 TEMAC / 无 UDP 栈）。

**要求**：列出**所有**可行通道，逐个给出**面积代价 + 风险 + 依赖**：

| 候选通道 | 面积代价 | 风险/依赖 |
|---|---|---|
| (a) **038 GPIO 板间链路**（1.5625 Mbps，余量 186×，**本来就在 043 集成队列里**） | ？ | 带宽需求仅 128×8bit×60Hz ≈ **61 kbps**，理论富余；但**副板输出接口要改**（现为 UDP） |
| (b) 把 052 网络栈并入 043 | ？ | 体量大（`u_udp` 3138 LE + ARP 488 LE + TEMAC…） |
| (c) 板载精简能量检测（不用副板 FFT） | ？ | **024 八段能量实测 4 DSP / 2275 LUT ≈ 594 MSlice**，已超 043 全部余量 |
| (d) 其它（由你提出） | ？ | — |

**必须给出**：哪条通道在 **241 MSlice** 预算内可行；若都不可行，明确写"都不可行"。

### Q2 柱形渲染的最小代价

**事实**：052 第四步的 128 柱是 **045 S2 整体渲染器**（2248 LE）画的，**没有精简版**（`STEP4`：「vendor/m6_s2 逐文件原样复用 task_045 S2」）。

**要求**：
1. 若**只要柱形图、不要 PCB 线稿场景**，最小独立实现多大？（给出设计估算 + 依据）
2. 能否**独立于 S2**？若要重写，明确这是新模块而非"复用"。
3. 043 已有的叠加底座（字幕/OSD 那套）能否承载柱形绘制？复用点在哪？

### Q3 装得下吗？

**事实**：043 `467A` 空闲 **MS 241 / LS 243**（slice 9316/9800）。

**要求**：把 Q1 选定通道 + Q2 渲染代价 + 必要的连线/仲裁，**汇总成一张面积账**，明确回答：

> **能否装入 241 MSlice？**
> - 能 ⇒ 给出总账与余量；
> - 不能 ⇒ 给出**还差多少**，以及**要从哪腾**（并说明与已排队的 041 双线性 / 038 板间链路 / 转场 P2b-P4 的**排产冲突**）。

---

## 3. 附加要求

1. **不得把"降级"算成回收**：例如假设"S2 只画柱形图所以省 X LE"必须在有依据的前提下给，且标注等级。
2. **依据等级照旧三档分明**：已有门级实测 / 模块级探针 / 纯设计估算，**不得混计**。
3. **不得动 043 生产树**（`467A`）与任何冻结件；评估用隔离原型或纯设计估算。
4. **M6 侧的 0x46 修复线并行推进**（位 2 要留作独立演示位），两条线互不阻塞。
5. **若评估结论是"不可行"或"需先腾空间"，照实写** —— 这比凑一个能过的数字有用得多。

---

## 4. 输出

一张评估表 + 明确结论（**可行 / 需先腾空间（差多少）/ 不可行**），并给出建议的落地顺序。

---

*浮浮酱 2026-10-06 ｜ 关联：`docs/DECISION_LOG.md` D-29/D-30/D-31、`archive/docs_2026Q4/PROJECT_SYNTHESIS_20261006.md` §四/§六、`task_052/doc/output/{STEP4_M6_DISPLAY_20261004.txt,STEP5_TF_AUDIO_20261004.txt}`*
