KoneFly/eg4s20bg256-media-terminal/visual/m6_full_display_integration/doc/output/ROUND2_BOARD_RECORD.md

# M6-FDI 第二轮上板记录

状态：**NOT_STARTED**。候选位 `deliverables/M6_FDI_R2_20261005_6B810152.bit`；SHA256 `6b810152e09eef36138e0ce8979712609a0828b18bf93de2b623fba79929b030`。未写实体TF卡、未烧录、未代签，BURN_INDEX待主人/规格方登记。

| 判据 | 结果 | 实际证据待填 |
|---|---|---|
| 受控TF真实PCM镜像及写后读回SHA/verify | NOT_STARTED | 卡型、工具、镜像SHA、素材SHA |
| 主板候选位SHA一致；副板7175ECC3保持 | NOT_STARTED | 烧录记录 |
| 上电PCB完整线稿且无错位/撕裂 | NOT_STARTED | 照片/视频 |
| 音柱/峰值帽/电流/节点/彗星随频谱 | NOT_STARTED | 输入与录像 |
| 底部128柱、静音收敛 | NOT_STARTED | 静音/有声录像 |
| 无卡/CRC错可观察诊断 | NOT_STARTED | 数码管/LED记录 |
| 连续运行≥10分钟稳定 | NOT_STARTED | 时长、异常、录像 |

本轮卡制作保留052第五步PCM受控格式，不表示第五步真音频应用已合入本FDI位。P7不能区分新位，应使用完整SHA。
