KoneFly/eg4s20bg256-media-terminal/visual/m6_full_display_integration/doc/output/ROUND2_PROJECT_LEDGER.md

# M6-FDI 第二轮候选位登记

2026-10-05；状态：BIT_READY / BOARD_PENDING。

| 项目 | 记录 |
|---|---|
| 工程 | 本包project/src，59份HDL；W2/S2/效果冻结 |
| 位文件 | deliverables/M6_FDI_R2_20261005_6B810152.bit |
| SHA256 | 6b810152e09eef36138e0ce8979712609a0828b18bf93de2b623fba79929b030 |
| 最终TD | td_run/bit2_final，Setup/Hold 0/0 |
| 面积 | 4717/4900 MSlice，余量183；16297 LUT/11418 REG/43×9K/5×32K/18 DSP/3 PLL |
| 标签卡 | CONTROLLED_TF_CARD_V2.md；已有四槽真实短PCM共卡镜像，正式长曲另行协调 |
| 副板 | 7175ECC3保持 |
| 主板P7 | 继承05401显示ID，不作为新位身份 |
| BURN_INDEX | 待主人/规格方流程登记，本包不修改外部索引 |
| 卡/烧录/板测 | NOT_STARTED，不代签 |

第一轮PROJECT_LEDGER、报告、位门禁及证据保留为历史；本记录对应新的第二轮SHA链。
