KoneFly/eg4s20bg256-media-terminal/deliveries/073_master_f35_slave_r69/slave_r69/model/MODEL_HANDOFF.md

# R69新场地模型：未准入，不得当成新bit

两轮R60原始传输及声学采集资格均通过；来源和SHA见MODEL_INPUT_BINDING.json。原128tap物理路径与25tap数字G合成152tap，默认ridge=.001的S拟合0.21956超原0.20门槛，默认失败保存在DEFAULT_RIDGE_FAILURE.json。

根授权后扫描ridge .001至.00001，并增加正常档20%留出频点及独立半幅交叉检查；S误差始终不合格，详见RIDGE_SCAN.json。最小ridge时S正常0.21497、半幅0.23157，正常模型在半幅数据误差0.29283。故不能归结为单纯正则化偏差。

| 物理/有效tap | S正常拟合 | S半幅拟合 | 正常模型→半幅验证 | 半幅模型→正常验证 |
|---|---:|---:|---:|---:|
| 128/152 | 0.21956 | 0.23644 | 0.29591 | 0.27400 |
| 192/216 | 0.19272 | 0.20650 | 0.27400 | 0.25444 |
| 232/256 | 0.18415 | 0.19631 | 0.26724 | 0.24820 |

长模型能减小自身拟合误差，提示截断长度有影响，但仍未通过两幅度独立验证，不能宣称延长tap即可解决。192/216结果见QUALITY_DIAGNOSIS_192.json；232/256为此前离线诊断，见QUALITY_DIAGNOSIS.json。任何长度调整都还需要真实时钟deadline/RTL回归及完整TD，未实施。

F参考反馈路径较稳定：原128/152结构下正常/半幅拟合0.09839/0.09678，双向交叉0.10296/0.10965。它与S的差异可作为下一轮隔离方向，本轮没有单独推广F系数。

两幅度S传函差的中位绝对增益/相位为0.534dB/3.409度，复数差范数相对正常约0.1695；F为0.196dB/1.201度、约0.0505。未事后增加或放宽两幅度差异阈值。

工具build_room_model.py通过原R68常数vh、双9K ROM逐字节重建自检，SOS及数字G保持。build_room_model_r02.py保留所有失败与候选选择证据。未输出新RTL，未启动TD，未覆盖原采集或旧封存。当前控制器仍应使用此前已交付的R68快测bit；R69目录仅是未完成研究候选。
