KoneFly/eg4s20bg256-media-terminal/visual/pcb_dynamic_layer/archive/v2/doc/output/RESOURCE_REFACTOR_REPORT.md

# pcb_dynamic_layer V2 资源重构记录

> 最后核对日期：2026-10-04  
> 维护者：pcb_dynamic_layer 执行方  
> 状态：用户批准的删粒子与路径③已完成，独立 TD 测量已交付；LUT 门禁仍失败。

本轮依据用户批准的 V2 删除圆周外侧弹射粒子系统，并执行串行 16bit 状态存储与集中地址规划；用户确认 W1、W2 都要按新预算分别实测。目标以实测为准，未为凑数缩减剩余冻结语义。

W2 的 trace/startF/node/bar/previous spectrum 统一进入 2048×16bit 同步 bank。共用一个注册乘法器、串行除法及统一频谱读取；T1/T2 仍按原字段、字序发布，commit 移到最后 T2 写排空之后。粒子、LFSR、8 点历史、P bank 及写口没有保留在 DUT。

W1 已实现仅柱顶连线：无效输入期几何构建和区间归并，发布冻结的 6144×24bit 行池；有效输入期只消费行表/区段预取 FIFO。行池与辅助构建 RAM 的占用分别报告，不把六个行池 ERAM32K 称作全模块存储。

源码与资源结果、告警和时序的唯一当前登记见 `V2_MEASUREMENT_REPORT.md`、`sim/td_result_v2.json` 和 `td_run/v2/*/source_manifest.json`。两项 LUT 上限未达成；W2 综合级 setup 失败，W1 最坏已测构建期限失败，未通过更改黄金或缩减线宽处理。

当前停止点是用户指定的独立测量交付，供规格方结合各板余量核定落点。本轮没有定板或主线集成。W2 的关键路径在最终 timing.txt 可复核；W1 的辅助构建区、行表、延迟与控制成本均已计入测量。不对未经实施的后续优化承诺具体节省量。

旧首次测量与 rev0/rev1/rev2 重构过程见 `archive/v1/doc/output/RESOURCE_REFACTOR_REPORT.md` 以及保留的 TD 历史原始产物。旧文档中“路径③尚未实施”“W1 暂停”和粒子冻结描述只属于 V1，不是本包当前状态。

按单一职责拆分状态更新、同步词 RAM、紧凑行池及独立验证；集中地址规划与共享算术体现 KISS/DRY，V2 只保留本轮授权所需功能。资源不足的事实照实交付，不增加超出测量范围的预留功能。
