KoneFly/eg4s20bg256-media-terminal/visual/pcb_dynamic_layer/archive/v2/START_PROMPT.md

# 任务启动 — M6 动态层（`pcb_dynamic_layer`）

> 签发：浮浮酱 ｜ 2026-10-02 ｜ 归属：视觉线（**离线，不碰主线** `m1a_top.v`）
> **粒度说明**：本包按主人 2026-10-02 裁定「**同一功能面的多个模块合并立项**」编制，
> 含**两个工作项**，**一次签包、一次验收**。（原 S2b/S3 两个独立包已并入本包，见文末说明。）

## 〇、你接手的是什么

「今非昔比」多媒体终端（安路 EG4S20BG256 / HX4S20C）视觉子系统 M6「PCB 线稿频谱」的
**动态层**：静态画面由已验收的 S2 渲染器负责（`iccoder_workspace/tasks/task_045_pcb_pixel_renderer/`），
**本包交付让画面"动起来"的两块拼图**：

- **W1 覆盖层光栅化**（原 S2b）：音柱粒子 8 点轨迹连线 + 柱顶连线，≈1150 条短线段/帧，逐行光栅化；
- **W2 帧更新器**（原 S3）：每帧 128 路频谱 → 状态表（渲染器与 W1 共同读取）。

## 一、必读材料（按此顺序）

1. `visual_workspace/START_PROMPT.md`（工作区角色与工作方式）
2. `visual_workspace/spec/M6_PCB_SKETCH.md`
   —— **§1 画面构成**（音柱/粒子/彗星视觉定义）、**§3 动力学**（§3.1~§3.8，全整数、每帧一次）、
   §6 参数表（全部寄存器化）、§8 黄金与验收
3. `visual_workspace/spec/M6_PCB_PORTING_PLAN.md` §3 的 S2b 行与 S3 行 + §2.3 模块划分
4. `visual_workspace/INTERFACE_CONTRACT.md` §9（集成契约：FIFO 位宽、合成级位置）
5. `iccoder_workspace/tasks/task_045_pcb_pixel_renderer/doc/output/behavior_spec.md`
   —— **渲染器的 `st_*_rdata` 读契约**（状态表 BRAM 在模块体外）与帧时序（650 拍 flush）
6. `iccoder_workspace/TASK_KICKOFF.md`（工作流与纪律）

## 二、W1 — 覆盖层光栅化（`pcb_particle_overlay`）

- **输入**：状态表读口（粒子 8 点历史位置、音柱峰值/柱顶、彗星位置 —— 字段与 task_045 契约及 W2 约定一致）；
- **处理**：每帧从状态表取几何 → **按行分桶** → 在像素流中**逐行光栅化**短线段
  （粒子轨迹连线 + 柱顶连线/峰值帽，三段绘制按 SKETCH §1 冻结视觉）；
- **输出**：覆盖层像素（颜色/使能），供 S6 的合成级与 S2 输出叠加；
- **硬约束**：与 S2 输出同像素时钟域、同帧节拍（flush 语义对齐）；输出序即扫描序（不得乱序）。

## 三、W2 — 帧更新器（`pcb_frame_updater`）

- **输入**：每帧 128 路频谱（8bit，语义见 SKETCH §3.1）+ 帧节拍（frame_tick 或自派生）；
- **处理**：按 SKETCH §3 全部动力学实现（§3.2 八段聚合与起音 → §3.3 走线生长 → §3.4 持续电流
  → §3.5 起音脉冲 → §3.6 节点与片内低频表 → §3.7 音柱与粒子 → §3.8 环上电流彗星）；
- **输出**：**状态表写口**（地址/数据/写使能）—— 写入 W1 与 task_045 渲染器共同读取的同一张表；
  表容量与条目按 task_045 契约与 SKETCH §3 字段清单核定；
- **硬约束**：全整数（SKETCH §3 已定）；参数全部寄存器化（§6，含与冻结值一致的默认值）；
  与 `st_*` 契约**逐字对齐**，不确定处先向协调方确认。

## 四、黄金与验收（两工作项合并验收）

| 工作项 | 黄金（JS 独立生成，LESSON-001） | 门禁 |
|---|---|---|
| W1 | 覆盖层 JS 实现的逐帧输出 | ① 独立 TB：固定状态输入 → 逐像素 0 失配；② **合体台**：与 S2 级联后整帧 = "S2 黄金 + 覆盖层黄金"合成结果，**逐位相等** |
| W2 | `pcb_model.js` 的逐帧状态导出 | 启动 **180 帧** + 播放段 N 帧（N 自定并说明），**每帧状态 dump = 黄金** 0 失配 |

- **TD 门禁**（两模块各自）：独立综合、0 错 0 警、资源如实报告、输出已寄存；
- 交付：RTL + TB + 黄金生成脚本 + 仿真日志 + TD 报告；`FINAL_ACCEPTANCE` 由浮浮酱独立验收后签发。

## 五、工作流

按 `TASK_KICKOFF.md`；仿真走 WSL/Verilator（长场景用 `VERILATOR_TEMPLATE`）；
先冒烟后全量；默认不生成 VCD；**先冻结两模块接口（与 task_045 契约对齐）再动 RTL**。

## 六、边界

- ❌ 不改 S2 渲染器（`task_045` 成果冻结）；
- ❌ 不实现频谱前端（S4 = `task_055`，独立包）；
- ❌ 不碰主线 RTL；不动 S6 集成（另行排队）；
- ✅ 本包只做 W1 + W2 两个模块。

## 七、上下文提示（易错点）

- SKETCH §3.6「节点+片内低频表 128/128 **已满**」—— 编号用满 7 位，不得溢出；
- 粒子字段（§3.7 PART_N=128）与音柱通道一一对应，索引语义别搞反；
- W1 的帧尾 flush（650 拍）期间**不得**插入杂散有效像素；
- W1 的 3px 线宽可参照 SKETCH §4 标签编码的"逐行区段"思想；
- 所有参数默认值必须与 SKETCH §6 表格逐项一致（冻结值）。

---

## 📎 附：粒度变更说明（2026-10-02）

本包由原 `rtl_handoff/pcb_particle_overlay/`（S2b）与 `rtl_handoff/pcb_frame_updater/`（S3）
两个独立包**合并**而成 —— 依据主人当日裁定「后续设计尽量在一个任务包内完成」。
原两包的 START_PROMPT 保留为指针（不再单独发送）。

**M6 剩余件**（供了解全貌，不在本包内）：
- S4 频谱前端 = `task_055_selfmade_fft`（独立包，规格完整）；
- S5 合体 / S6 集成上板 / S7 接真实频谱 = **待立为一个集成包**（按新粒度，届时不再逐段拆包）。
