KoneFly/eg4s20bg256-media-terminal/visual/pcb_dynamic_layer/archive/v1/doc/output/RESOURCE_REFACTOR_REPORT.md

# W2 首次 TD 面积门禁与重构报告

> 最后核对日期：2026-10-04  
> 维护者：pcb_dynamic_layer 执行方  
> 状态：首版面积不通过；已暂停后续 W1 开发，优先在原授权范围内重构 W2。

## 实测结果

唯一原始来源：`td_run/w2_gate.area`，控制台日志 `td_run/w2_area.log`。命令为本任务目录内 `td_commands_prompt.exe w2_area.tcl`，进程退出码 0。

| 指标 | TD optimize_gate 实测 | 任务目标 | 结论 |
|---|---:|---:|---|
| #lut（LUT 等效利用） | 9788 | ≤2500 | 不通过 |
| #Total_luts（不同宽度 LUT 实例） | 7440 | 不用于替代 #lut 门禁 | 记录 |
| #reg | 2385 | 无单独冻结上限 | 记录 |
| 层次表 seq（含 I/O 寄存） | 3490 | 无单独冻结上限 | 记录 |
| #dsp | 9 | ≤2 | 不通过 |
| #bram9k | 26 | 按实测报告 | 记录 |
| #bram32k | 0 | 本次为 W2 内部存储，不含外部 P bank | 记录 |

本次直接以宽内部接口模块作为面积顶层，PAD 数超过器件引脚数量；该工程只用于逻辑映射面积审计，不是可布局布线或可烧录的板级工程。不得从该结果报告 Setup/Hold WNS、Fmax、引脚通过或板级 PASS。

新增告警签名：`SYN-5011 Undriven pin ... bea[0]/beb[0]`、`SYN-5025 Using 0 for all undriven pins and nets`、`SYN-6562 RAM init ignored`。当前没有本任务既有 TD 基线，这些告警均待独立审查，不能直接称为“继承告警”。

## 原因与证据边界

日志显示 RTL 产生 11 个 multiplier macro，映射后为上述 DSP 数量；虽然主乘法寄存器复用，其他整数表达式仍被综合成乘法宏。宽 integer 计数/运算、动态字段选取和分散 RAM 端口也形成较多 mux。日志确认推断出六个 BRAM 状态存储，宽记录经物理拆分占用较多 9K。

以上是结合日志和源码的重构判断，尚未逐实例完成面积归因；不能承诺某一项修改的确定节省数量。

## 保持现有规格的重构路径

1. 所有索引改为实际所需的有限位宽，显式扩展算术符号，避免 32bit 通用选择器。
2. 常数乘法用移位加法；所有必要可变乘法复用同一 16×16 运算单元，不改变 floor/饱和语义。
3. 将状态访问统一为串行 16bit 词接口，按固定地址规划集中存储，避免宽记录物理拆分和多个高扇出字段 mux。
4. 同步 RAM 通过运行时初始化清零，不依赖被忽略的初值；逐项审查 RAM byte-enable 告警。
5. 重构后先对已生成的全部默认黄金逐写口对拍，再重跑独立 TD。资源达到冻结目标后才推进 W1。

候选内部地址规划（与对外 T1/T2/P 无关，不改变任何对外字段）：

- bank A：2048×16，trace 0..1023、startF 1024..1151、node 1152..1407、bar 1408..1663、prev 1664..1727；
- bank B：2048×16，每粒子 16 字，包含原 168bit 历史、energy/life、Q4 位置和速度；对外 P 仍只发布冻结的 12 字。

物理 ERAM 类型和块数仍需 TD 测量；这里的形状是重构计划，不是资源 PASS。原粒子数、历史点数、分辨率、坐标表示、默认参数、正式端口和逐位判据保持冻结。

## 两轮优化后的实测与停止点

| 修订 | #lut | #Total_luts | #reg | #DSP | #ERAM9K | #ERAM32K |
|---|---:|---:|---:|---:|---:|---:|
| rev0：首版 | 9788 | 7440 | 2385 | 9 | 26 | 0 |
| rev1：计数器限宽、常数移位加法 | 9331 | 7217 | 2263 | 1 | 26 | 0 |
| rev2：共享频谱读数、进一步限宽 | 6646 | 4642 | 2204 | 1 | 26 | 0 |

rev2 相比首版减少 3142 LUT（32.1%），但仍为 2500 上限的 2.66 倍。DSP 达标，LUT 门禁不通过。当前暂停 W1 与主线集成，不把这版作为资源合格交付。串行 16bit 状态存储仍为候选重构，尚未实施，不能承诺仅此一步即可达标。

当前实际源码与 `td_run/rev2/pcb_frame_updater.v` 一致，SHA256 为 `f2baa756322e81aa4ffc7877ef88ee45b2aad37397e2c7e74d889e4ff25e1806`。rev2 原始日志/面积报告为 `td_run/w2_area_rev2.log`、`w2_rev2_gate.area`、`w2_rev2_rtl.area`；绑定关系在 `td_run/rev2/source_manifest.json` 与 `sim/td_result.json`。rev1 是中间面积记录，不替代当前源码的 rev2 证据。

Verilator DUT 已完成 8 类刺激各 300 帧，共 2400 帧；另有 overrun 和两类中途复位后重入各 300 帧。每帧直接从真实写口检查 T1 512 次、T2 140 次、P 1536 次的地址、字序及数据；默认场景与独立模型零失配。最高实测 22757 个控制周期，即 50MHz 下 0.45514ms，低于 833333 周期。该时间只约束测试过的默认参数刺激。

所有测试在接受频谱后立即扰动现场输入，当前帧结果仍正确；overrun 的额外 tick 也使用扰动后的频谱。复位分别发生在接受后 200 拍和 P 写地址 100 有效时，均经真实端口检测后重新播放黄金。移位 `>>>8` 改 `>>>7` 的隔离变异被 T1 黄金杀死，原始 RTL 未被修改。

lint 使用 `--Wall -Wno-BLKSEQ`，无其他告警；BLKSEQ 只放行过程局部算术临时量的风格，位宽告警未关闭。证据分别为 `sim/sim_result.json`、`sim/mutation_result.json` 和 `sim/logs/`。`cfg_boundary`、W1 RTL/像素对拍、S2 合体 smoke、外部 P bank 实例及布局布线尚未完成。RAM byte-enable 告警尚未消除，不能称为综合净表无告警或板级 PASS。
