KoneFly/eg4s20bg256-media-terminal/docs/研发流程图_20261022.png

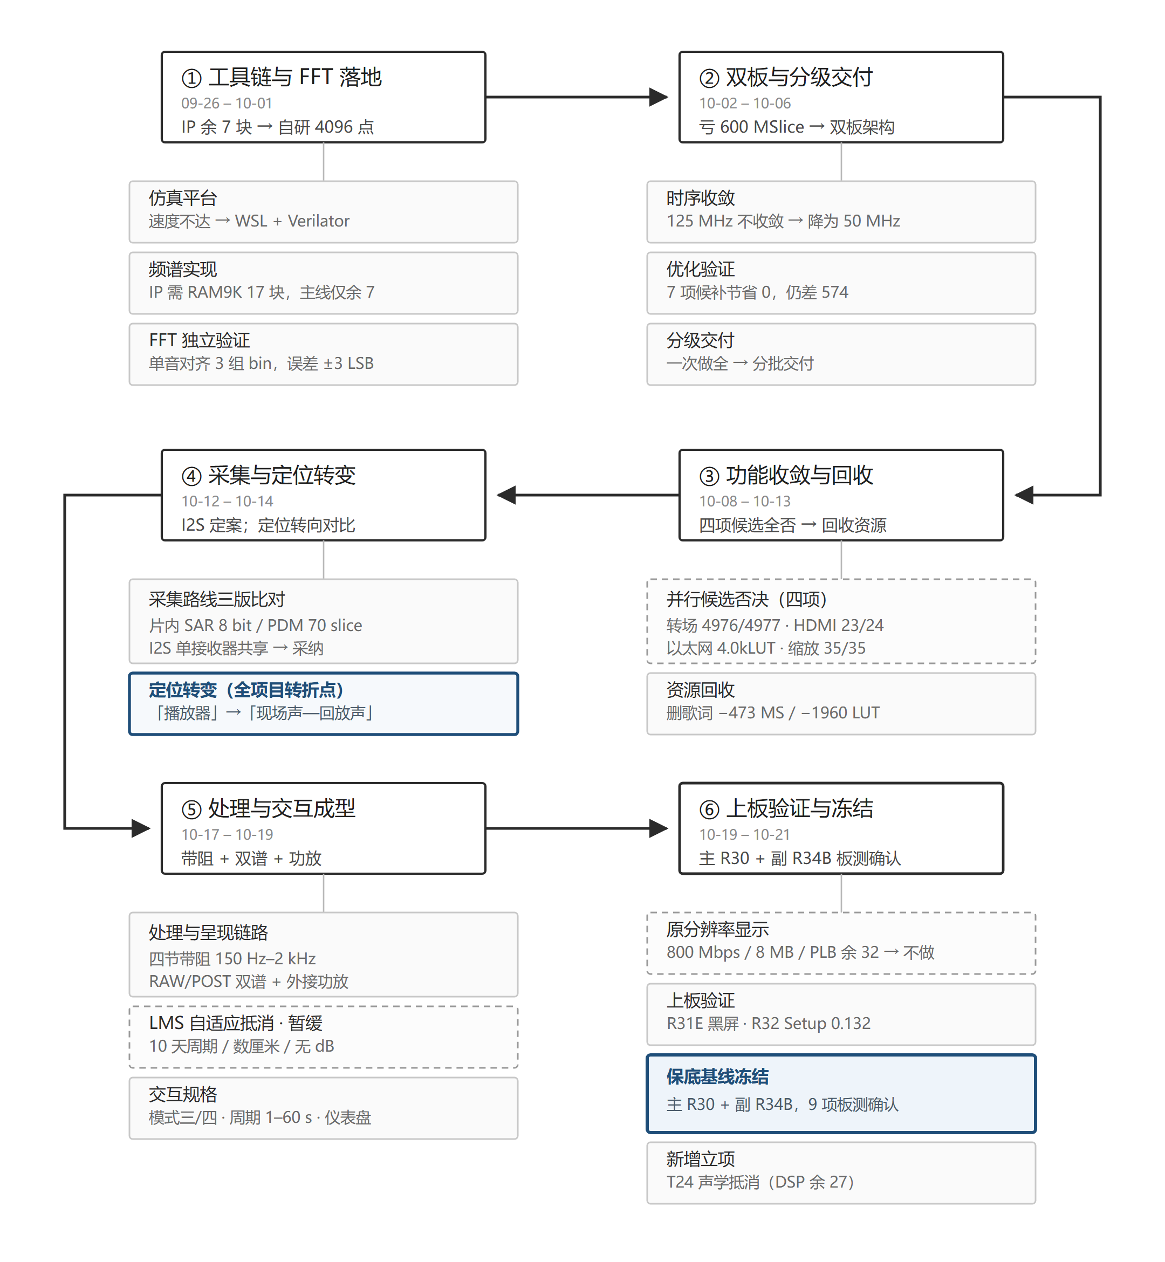
docs/研发流程图_20261022.png
