KoneFly/eg4s20bg256-media-terminal/visual/m6_full_display_integration/project/assets/PCB.BMP

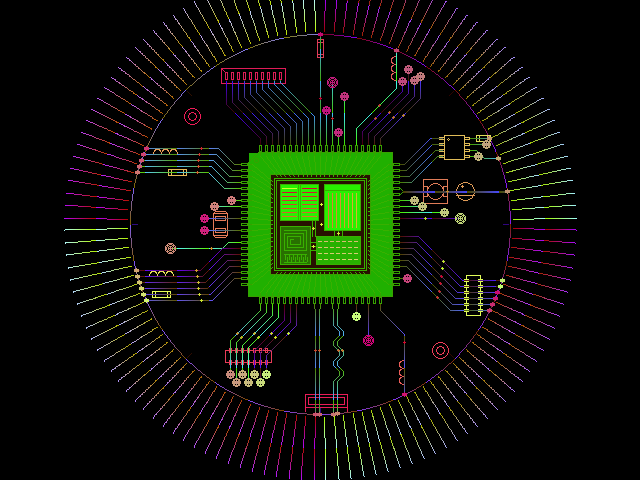
visual/m6_full_display_integration/project/assets/PCB.BMP
