KoneFly/eg4s20bg256-media-terminal/deliveries/073_master_f35_slave_r69/slave_r69/CURRENT_BUILD_STATUS.md

# R69构建状态

R69 UART诊断位已封存登记，等待新模型大场地降幅和变频实测。

更新：2026-11-03T16:29:22.801525+08:00
