KoneFly/eg4s20bg256-media-terminal/visual/color_glow_renderer/VERIFICATION_CONTRACT.md

# M3 验证契约

## 场景列表

| ID | 刺激 | 可观察检查项 |
|---|---|---|
| CG01 | 帧中复位并释放，随后完整VS | 未锁帧valid=0/pixel=0；首完整帧恢复 |
| CG02 | 8路全0、theme0/glow2 | 全有效区为背景0022，只有x48..591/y420为08A5；307200 valid像素 |
| CG03 | 固定阶梯[32..255]、theme0/glow2、phase0 | 与stair_soft固定栅格/渐变/亮点全帧逐像素一致 |
| CG04 | 全255、theme1/glow3、phase13 | 与full_aurora全帧一致；四级色与外光均非空 |
| CG05 | 边界向量、theme2/glow0、shift2、phase7 | 与quarter_sharp全帧一致；保留栅格/渐变/亮点，无外光 |
| CG06 | 同一全255画面依次glow0/1/2/3 | 核心像素不变；层集合单调增加，模式含义精确 |
| CG07 | KEY0循环0/1/2/0 | 每次下一场提交后24个核心色逐项匹配，几何不变 |
| CG08 | KEY3从默认2连按4次 | active序列2→3→0→1→2，必须由公开像素层判断 |
| CG09 | KEY1冻结后改变能量跨3帧再解冻 | 核心/光晕边界保持，解冻首次提交反映新值 |
| CG10 | KEY0/1/3同拍及KEY2同拍覆盖 | 最终画面证明独立更新与0/0/2复位优先级 |
| CG11 | 按键在commit前/同沿/后1拍 | 旧pending同沿提交，新事件下一帧生效；无帧内撕裂 |
| CG12 | video_timing_data寄存器源直连 | 下降沿观察x=0..639；固定边界无1像素右移；与Task020相位锚一致 |
| CG13 | DE超过640、有效行超过480后新VS | 越界pixel=0且valid跟随DE；不回绕，新帧恢复 |
| CG14 | RGB565层级变换 | 21个reference锚点逐项一致；近/远光必须分通道右移 |
| CG15 | 连续至少132帧P128黄金包络 | 输出无X/Z，背景/光晕稳定，周期稳态画面重复；不要求伪3D/M5状态粒子 |
| CG16 | 固定能量/theme/glow，frame_phase连续0..31 | 栅格位置不变；亮点按固定hash移动，至少一个锚点亮灭变化；帧内不变 |
| CG17 | 核心横纵坐标遍历一个8×8单元 | 仅cell_x/cell_y均0..5的36像素发光，其余28像素为背景；亮顶两行不打孔 |

## TestBench架构要求

组合输出按最新模板在下降沿/下一上升沿前观察；寄存器配置在上升沿NBA后检查，但最终判定必须回到公开像素。TB不得读取DUT内部坐标或layer作为黄金。几何期望用reference固定矩形填充，禁止复写`offset`判定链；颜色使用固定core/cap/near/far常量表，不在TB重新计算分通道位移。CG07–CG11/CG16使用`reference/FRAME_EVENT_VECTORS.md`的固定逐帧期望。

每帧检查307200个有效像素和消隐输出，零能量场景必须检查valid计数。看门狗每场景≤12帧，长跑CG15≤140帧。失败记录场景、帧、x/y、期望/实际RGB565。默认不生成VCD；脚本删除旧vvp/log/result后重建，编译失败不得运行旧binary。

变异证伪至少覆盖：核心右边界51→52；栅格阈值6→7；frame_phase从hash移除；近光错误使用整个16bit右移；集成x递增回退Task013旧条件。每个变异保留独立日志和真实失败计数，汇总由脚本生成。

## 验收门槛

CG01–CG17全PASS、0警告0错误、X/Z=0；固定黄金副本逐位一致。TD针对EG4S20BG256，25.2MHz收敛，资源满足目标，SDC无无依据false_path/multicycle。输出相位必须在预期寄存器时序源下验证。模块级结论与集成/上板分开；后续A/B bit在出bit前提交预期映射，复用Task020修复ADC并逐引脚核对。
