KoneFly/eg4s20bg256-media-terminal/visual/eight_bar_renderer/VERIFICATION_CONTRACT.md

# 八柱渲染器验证契约

## 场景列表

所有期望通过公开输出观察；禁止读取DUT内部坐标作为黄金坐标。固定几何向量见reference目录JSON；V07—V10与V13的固定逐帧刺激和期望见 `reference/FRAME_EVENT_VECTORS.md`，必须覆盖其中A—E及所有子场景。

| ID | 刺激 | 可观察检查项 |
|---|---|---|
| V01 复位/启动 | DE有效中拉低复位，再释放；等待VS低后重新产生完整帧 | 复位/同步等待期像素=0且valid=0；未采到VS低不接收残帧；下一完整帧从(0,0)开始 |
| V02 全零 | 所有能量0，完整一帧 | 307200有效像素，全部RGB565=0；消隐valid=0且像素0 |
| V03 全满 | 所有能量255，shift0 | 矩形固定区间165..419；97920着色像素；每柱48×255，间隔16 |
| V04 边界阶梯 | [0,1,31,64,127,128,254,255] | 对golden/boundary整帧比对；特别检查top−1/top/bottom/bottom+1与左右边缘各±1 |
| V05 幅度 | 边界阶梯分别用shift1/2/3 | 对half/quarter/eighth全部固定矩形逐像素比对；着色20544/10176/4992个 |
| V06 三配色 | 每路255；KEY0依次切换0/1/2/0 | 下一提交前旧颜色不变，提交后逐像素匹配各色表；几何/valid计数不变 |
| V07 能量快照 | 有效区中途把所有能量从0改255 | 当前帧保持全黑；下一次提交后的完整帧为全满；不能只检查内部锁存标志 |
| V08 冻结/解冻 | KEY1冻结后持续改变输入，跨越至少3次VS | 各帧输出像素仍等于冻结前快照；解冻提交后反映新输入；KEY1在提交同沿则延后一帧 |
| V09 组合键 | KEY0/1同拍；KEY0/1/2同拍；KEY3及sw高两位变化 | 独立更新、KEY2优先、保留位无影响；通过最终颜色和柱高证明，不能仅检查pending |
| V10 更新边界 | KEY0分别在VS下降前1拍、同拍、后1拍；开关同类稳定刺激 | 同沿KEY0仅影响下次提交；sw按当前采样值本次提交；一帧内不能混色/变高 |
| V11 DE时序 | 连续至少3完整帧800×525 | 每行640、每帧480行；0拍像素对齐；HS/VS低有效，消隐不着色，首末像素均不偏移 |
| V12 坐标越界 | 一行DE保持高超过640拍；注入第481有效行，再输入VS低 | x≥640或y≥480像素黑且valid仍跟随de；不回绕；新正常帧恢复，VS低强制valid0 |
| V13 帧中参数 | 非VS行消隐内按键/拨码改变 | 不能在H-Blank立即应用；直到场提交后的完整帧才变更 |
| V14 释放时VS已低 | 复位释放后VS维持低，随后给正常帧 | 能采集第一次能量快照并正确显示，不多等一整帧 |

## TestBench架构要求

- TB独立驱动外部800×525时序，可另例化只读 `video_timing_data` 做兼容性检查，但不得用DUT计数器确定期望。
- 驱动与采样错开相位，说明0拍组合口的建立时间；使用帧/行计数和有界等待VS事件。每个等待需看门狗，单场景最多12帧，每次提交等待最多2帧，卡住即FAIL。
- 几何黄金使用固定坐标矩形填充，禁止在TB重新写 `u=x−64; band=u>>6` 生成期望；禁止复写RTL公式自证。色表来自固定reference；独立核查RGB565数值。
- pending场景用按帧预先列定的固定期待画面，不读取DUT内部状态；至少保存失败坐标、期望值、实际值、帧序号、刺激场景。
- 全零仍需检查valid数，避免全程invalid伪PASS。检查X/Z、复位后可观察口稳定。
- 不默认生成VCD。调试需要时开关控制；交付按项目纪律清理临时波形。
- `sim/run.sh` 定位自身目录、任一编译失败立即退出，不能运行旧二进制；支持项目工具路径。日志是执行产物，不允许脚本只打印PASS。
- `sim_result.json` 至少包含command、exit_code、各场景checks/failures、total_checks、总status、运行时间。只有真实检查全通过才可PASS。

## 验收门槛

1. 0错误0警告，V01—V14全部执行并通过，独立重跑结果可复现。
2. 像素检查使用固定几何数据；异常测试检查输出，不是固定延时后假定正确。
3. TD针对EG4S20BG256，约束输入/输出路径并说明外部延迟预算；不把全路径设false_path。必须给出资源和25.2MHz时序；板级结论仅能来自后续完整工程。
4. 本任务没有SD/媒体加载，系统容错（拔卡/坏BMP）不适用，原因是不存在该输入。后续媒体集成再按SOP定义功能、稳定性、容错三层场景。
5. HDMI集成另行验收A/B源、RGB扩展、ready行为、连续有效和SOF/EOL；此包的模块仿真不能替代加密IP实物取证。
6. 最终上板必须看到八柱变化；仅锁定LED、浏览器截图、模块TD通过均不能写硬件PASS。
