KoneFly/eg4s20bg256-media-terminal/visual/energy_envelope/VERIFICATION_CONTRACT.md

# M2 验证契约

## 场景列表

| ID | 刺激 | 可观察检查项 |
|---|---|---|
| E01 | 异步复位、释放同步期间tick、重新复位 | 输出清零，释放完成前不更新 |
| E02 | reference全部6组序列 | 每个tick后8路逐位等于固定期望 |
| E03 | 8路分别输入[0,1,3,7,64,128,254,255]，初始0，attack1 | 首次输出[0,1,2,4,32,64,127,128]，无lane串扰 |
| E04 | 不给tick，任意改变输入/所有控制100周期 | 每周期输出保持，含bypass=1时 |
| E05 | 初始128，hold=1,target255,bypass=1，多tick | 保持128；取消hold下一tick变255 |
| E06 | 小差值1..7，release3，目标0 | 每tick减1直至0，不停在1，不下溢 |
| E07 | 攻击1追到192后目标突然0，release3 | 下一tick168，再147，方向翻转正确 |
| E08 | 配置tick前/同采样沿/后一拍改变 | 满足建立保持的同沿新值本次生效；之后改变下次生效 |
| E09 | 连续高tick两拍，初始0,target255,attack1 | 分别128、192；不私加边沿检测 |
| E10 | bypass切回正常，255→0,release3 | bypass至255后取消，下一tick223 |
| E11 | 输出接M1同域同VS采样事件，初始0,target255,attack1 | 前三帧M1快照0/128/192；公开像素top空/292/228，不能读取M1内部快照作黄金 |
| E12 | 所有速率0..3、目标不变 | 不过冲、0..255、最多255tick到目标；每lane独立 |

## TestBench架构要求

独立固定向量优先，不能复写DUT移位公式自证。交叉方法可用整数区间计数，期望仍保留固定向量。驱动下降沿、输出寄存器在上升沿NBA后检查；该时序与M1组合像素采样方法不同，E11按M1正式TB约定执行。

每场景看门狗；长收敛测试每次最多256tick；无tick保持必须逐周期断言。失败记录lane/周期/expected/actual，检查X/Z。脚本遇编译失败不运行旧binary，非零失败退出，默认不开VCD。sim_result.json记录实际checks/failures/status和运行命令。

## 验收门槛

E01—E12全通过，0错误0警告；验收方独立重跑。至少一种变异：删除向上取整偏置导致尾端卡住，或下降改加法导致E07失败；报告原版与变异版真实失败计数，禁止预填结论。TD25.2MHz收敛，无无依据false_path/multicycle，0DSP/0ERAM；超过LUT估算需反馈。无HDMI IP调用，本包不新增A/B bit；主线仍负责已定义HDMI A/B与ready验证。
