KoneFly/eg4s20bg256-media-terminal/visual/spectral_ridge_renderer/VERIFICATION_CONTRACT.md

# M4 验证契约

## 场景列表

| ID | 刺激 | 可观察检查项 |
|---|---|---|
| SR01 | 帧中复位/释放/VS重定位 | 未锁帧输出0；完整帧恢复 |
| SR02 | 全0能量 | 仅背景和544像素地平线，valid=307200 |
| SR03 | rising_line固定向量 | 全帧逐像素黄金；9个高度锚含64/96/127/128/575 |
| SR04 | zigzag_topography | 正负diff交替，全帧与phase13/mode3黄金一致 |
| SR05 | dot_cloud | 点阵上下云、辉光与13像素锚一致 |
| SR06 | mode 0/1/2/3 | 主脊线不变，辉光/点阵/回声按定义增量出现 |
| SR07 | theme 0/1/2/0 | 几何不变，固定亮/核心/近/远色匹配 |
| SR08 | shift 0/1/2/3 | wave_y按右移能量变化，无有符号越界 |
| SR09 | KEY1冻结后输入变化再解冻 | 波形高度保持，phase点阵继续移动；解冻采新值 |
| SR10 | KEY组合与KEY2优先 | 公开像素证明theme0/freeze0/mode2复位 |
| SR11 | commit前/同沿/后按键 | 旧pending本帧，新事件下一帧 |
| SR12 | 下降斜率255→32 | x64..127高度单调下降，固定x96=143、x127=35 |
| SR13 | band7末段 | x512..575高度恒e7，不回绕band0 |
| SR14 | phase 0..31 | 脊线不动，点阵亮灭按冻结表；帧内稳定 |
| SR15 | Task020寄存器时序源直连 | x=0..639，固定锚无1像素偏移 |
| SR16 | DE>640/行>480后VS | 越界黑且valid跟随，下一帧恢复 |
| SR17 | P128至少132帧 | 无X/Z；波形连续，稳态周期重复 |

## TestBench架构要求

组合输出在下降沿/下一采样沿前观察；配置寄存器NBA后检查但最终以公开像素判定。TB独立持有x/y，不读DUT内部。全帧期望使用reference固定案例和独立加权形式`(e0*(64-f)+e1*f)>>6`，不得复制DUT signed-diff表达式；hash亮灭使用冻结常量表。

每帧统计307200 valid并检查消隐；每场景≤12帧，长跑≤140帧。失败记录帧/x/y/能量/期望实际。脚本清旧产物，编译失败不运行旧binary，默认不开VCD。

变异：diff改无符号、`>>>6`改`>>>5`、band7 e1改band0、hash删phase、x相位回退。五支保留独立日志和真实失败计数。

## 验收门槛

SR01–SR17全PASS、0警告0错误、X/Z=0；黄金副本逐位一致。TD满足资源/时序，报告DSP实际映射。模块结论不代替A/B上板；024真实接入另做集成契约，明确TSMIN≥35拍及tick后≤34拍延迟。

---

## 分层与时间预算（**2026-09-18 规范必填**，验收方补）

| 层 | 内容 | 预算 |
|---|---|---|
| **L0 冒烟** | 编译 + **SR02**（静音：仅背景 + 544 像素地平线）| **< 30 秒** |
| **L1 快速** | SR01~SR10（模块级，每场景 ≤12 帧）| **< 5 分钟** ← **日常迭代默认档** |
| **L2 全量** | + **全帧逐像素黄金**（640×480 = 1,228,800 像素锚比）+ SR11~SR17 + **SR17 长跑（≤140 帧）** + **5 变异** | 可过夜/后台 |

**`sim/run.sh` 必须提供 `PROFILE=quick|full`（`quick` 为默认）**，并登记各层实测耗时。

## 提速措施（**规范必填**，验收方补）

| 措施 | 落实 |
|---|---|
| **fail-fast** | 首个失败即 `$finish` + 同类错误打印上限 **20 次**（防日志爆炸）|
| **超时三态** | 超时记 **`TIMEOUT`**（纯墙钟、无判据证据）——**不计 FAIL、不计 PASS** |
| **进度心跳** | L2 的 **SR17 长跑**周期性打印帧号进度（保证日志非空、可判"在跑"还是"卡死"）|
| **单场景可跑** | 支持 `SCEN_ONLY=SRxx` |
| **不缩尺寸** | **全帧 640×480 / 307200 valid 是判据的一部分**——**禁止**为提速裁剪 |

## 边界与规模覆盖（**规范必填**，验收方补）

| 项 | 内容 |
|---|---|
| **位选掩码自查** | 插值加权 `(e0*(64-f)+e1*f)>>6` 的比较与移位**须全位宽**；`f[5:0]` 位宽须覆盖 0..63，**不得截断** |
| **极值边界** | **SR13（band7 末段不回绕）** = 本模块最易错边界，**必须**保留 |
| **有符号边界** | 下降斜率（255→32）与负 diff（SR04/SR12）**必须**覆盖——**禁止把 signed diff 写成无符号**（已列为变异体）|
| **规模梯度** | 全零（SR02）→ 递增（SR03）→ 锯齿（SR04）→ 点阵（SR05）|

## 时序要求（**2026-09-18 起必填**，验收方补）

- **如实报告** `Setup WNS` / `Hold WNS` + **违例端点数**（TD 直读，**不美化、不选择性汇报**）；
- **不得使最差路径恶化**（相对 **Task 020 视觉链底座**）；
- ⚠️ **「与官方基线同值」只说明是继承缺陷，不构成接受理由**——全工程时序收敛是**独立必修课题**（`PROJECT_STATUS.md` §5）；
- **本任务只负责「如实报告 + 不恶化」**，不负责全局收敛；**禁止**用"官方既有/官方也这样"之类措辞描述违例。
