KoneFly/eg4s20bg256-media-terminal/visual/m6_full_display_integration/doc/output/M1_SDRAM_SELFTEST_REPORT_20261006.md

# M1独立SDRAM自检交付（2026-10-06）

状态：**软件与原生TD通过；M1真板待测；完整M6-FDI未修复验收**。

本轮承接用户确认S1彩条及全部给定读数正确，停止在完整工程中连续叠加探针，进入分层计划的SDRAM层。S1板测补充封存为 `S1_SELFTEST_BOARD_RESULT_20261006.json`；未报告原始逐项数值、≥10分钟时长或KEY1重复，不代签这些项目。

## 烧录文件与边界

- **主板位**：`deliverables/M6_FDI_M1_20261006_BDDEBAE7.bit`，629643B。
- SHA256：`bddebae74ee1b5ca0abe0b3dc914ab5b73008c0b272dad8b7961b5021f6ccbb6`。
- 使用**HDMI-B**；副板仍为7175ECC3，副板不重烧。受控TF不重制；本诊断位不消费TF或网络链。
- 工程：`experiments/sdram_selftest_M1/`，顶层 `fdi_sdram_selftest_top`，14个实际综合HDL文件。
- S1时钟、视频及HDMI资产逐字节复用；A4 `fdi_sdram_cmd_engine.v`、`fdi_sdram_refresh_timer.v`逐字节复用。引擎保持T_INIT=10000、T_RP/T_RCD/T_WR/T_MRD=2、T_RFC=4、CAS=3、DQ_LAT=1、BL=8、刷新间隔781拍，原CTRL 50MHz/存储180°出口及DQ预捕获不变。
- 新增独立请求方、首错快照和BASE域捕获。原加载器、SPI、CRC、完整W2/S2工程、052/043、副板及旧位不改；未自动烧录或登记BURN_INDEX。

## 最终原生TD门禁

签核目录 `td_run/bit_m1_signed/`，唐朝TD v6.2.168116、EG4S20BG256；最终布线数据库出位。

| 项目 | 实测 |
|---|---:|
| MSlice | **953 / 4900**（19.45%，余3947） |
| LUT / REG | **2924 / 2542** |
| ERAM9K / ERAM32K | **10 / 0** |
| DSP / PLL | **0 / 3** |
| Setup WNS / 违例 | **+2.321ns / 0** |
| Hold WNS / 违例 | **+0.004ns / 0** |
| 最终原生告警 | **未报告** |
| 原生路由检查 | 无多驱动、无本地时钟路由、无异常时序路径 |

Hold只有4ps正余量，按0/0门禁通过，不宣称充裕物理裕量或真板长期通过。953 MSlice是独立诊断工程占用，不代表完整M6-FDI容量已收敛。

精确CDC：9个首级数据端点逐条原生查询成功；其中7个有同步发射源，2个为硬PLL异步锁定输出，由门级源锥证明。219个动态冻结结果D端采用MC4 setup / MC3 hold；无其他PIXEL、源D、CE别名豁免，alias OPEN=0。165位M1结果中的地址bit9..17共9位由真实门级buf链证明恒零，不作动态MC豁免。M1结果toggle经两级同步后再等待两拍才捕获，首通过后仅首次故障能替换快照，CTRL功能复位不抹掉已发布首错；KEY1清除。

原生结构核验：S1独立计数器58位保留，参考计数29位全为LOGIC而非RIPPLE；M1结果156个动态源FF与165个捕获FF共321个物理FF核验；32位DQ预捕获核验为SDRAM I/O输入FF，MEM时钟捕获、CTRL时钟驱动输出，未变更为同相方案。

过程记录保留：首探针门级MCP有30个优化别名未命中，未签核；增加诊断快照/捕获寄存器保留属性后，只剩9项无动态源地址常量，经buf链证明撤销18条MC规则并重新综合。最终约束加载门级为2827 LUT/2503 REG、Setup +0.709ns/Hold +0.644ns、0/0。布局为935 MSlice，Setup −0.521ns（2违例）、Hold −0.061ns（52违例），并有1582条过程别名告警；物理端点重映射与布线后达到上述最终门禁。过程失败/告警不作为签核结果，详见工程 `doc/output/PROCESS_RECORD.json`。

## 自检内容及验证

8个BL8块字地址：040000、0400F8、040100、0401F8、080000、0800F8、100000、1800F8，共64字，覆盖全部4个bank及行/列边界附近。每字分别写入地址编码与反码，区分邻字/拍错位。每组执行64次单字写、8次即时BL8读、保持200000 CTRL拍（4ms）并验证出现刷新确认、再8次BL8读。

两组完成后冻结“通过”快照，此时累计128写、256正确读字；保持刷新，持续每4ms巡检64字。后续首错替换成功快照，此后冻结；16位运行计数饱和，避免绕回误读。请求/响应或初始化等待超65535 CTRL拍生成明确错误，视频始终独立输出彩条。

Verilator 5.032，Verilog1364-2005与SV测试台，**实际开启--assert**；编译输入副本及SOURCE.sha256绑定最终HDL。11个SDRAM场景通过：正常两组+刷新保持+继续巡检、保持期间数据破坏、漏中间拍、错地址、初始化超时、请求超时、响应超时、CTRL复位保留/KEY1清除并重跑、成功后数据破坏、漏末拍、响应类型错误。正常模型结果flags=007F、128写/256读、513次刷新；成功后破坏巡检能更新为flags=00FF、首错code=6。

实际顶层16个诊断页映射、32位预期/实际值的高低半字以及S1异常标志断言通过。新请求方/捕获模块默认严格lint各0错误0告警；完整应用边界lint0错误、**179条告警OPEN**（SDK/IP替身、继承端口及未消费信号等，分类与原文归档，不压制）。HDMI加密内部、实际PLL和物理存储延迟不由模型签核；模型结果不能替代真板。

## 上板操作与固定读数

主板烧BDDEBAE7，保持原接线和HDMI-B。KEY1是RTL名称、对应本板**丝印KEY2**；按约1秒，放开等2秒。彩条应持续正常；SW0只切换诊断显示，任何状态都不门控视频。

**SW0=1**，SW[3:1]选000～111，每页至少等待0.3秒后读数：

| 页 | 前缀 | 通过预期 | 含义 |
|---|---|---:|---|
| 000 | d0 | **05466** | M1版本 |
| 001 | d1 | **00127** | 初始化、写入、即时读、保持读、反码、刷新、首次通过，共7位全部置1 |
| 010 | d2 | **00000** | 错误与失败阶段；0表示没有发布错误 |
| 011 | d3 | **00255** | 冻结地址低16位 |
| 100 | d4 | **00024** | 地址高5位；完整最后字地址1800FF |
| 101 | d5 | **23130** | 预期数据低16位（5A5A） |
| 110 | d6 | **23130** | 实际数据低16位 |
| 111 | d7 | **65280** | 固定显示校准 |

**SW0=0**，P页：P0=05466；P1=256（冻结正确读字数）；P2=128（冻结完成写数）；P3为首通过时刷新次数（模型513，判据为有刷新，不硬签真板精确次数）；P4应16639（S1计数、时钟/复位监测健康）；P5/P6均50597（预期/实际数据高16位C5A5）；P7=65280。M1还没有发布快照时，P1/P2/P3临时显示S1的CTRL/MEM/PIXEL相对频率读数。

首次通过之后继续巡检，正常d/P快照保持不变。**先记录上述固定值，再保持≥10分钟复读、KEY1复位后复现**。通过后进入原TF读链自检。

若失败，保持运行不再复位，记录全部d/P页及彩条现象。d1 bit7置1为失败（首次通过后失败时常见255）；d2低8位为错误码，高8位=`{请求方state[2:0],引擎state[4:0]}`，不是十进制拼接。错误码：1初始化超时，2请求接收超时，3响应超时，4BL8拍数异常，5拍地址异常，6数据不匹配，7响应类型错误，8保持期间未观测刷新计数进展，9非法自检态。失败时d3/d4为地址、d5/P5为完整预期32位、d6/P6为实际32位，P1/P2/P3冻结进度。

仅彩条正常、只有d2=0或尚无结果（d1=0）不能判SDRAM通过。此位通过也不等同完整PCB线稿、动态或黄金双CRC通过。

## 证据与下一层

`M1_SDRAM_SELFTEST_EVIDENCE_INDEX_20261006.json`绑定源、仿真输入/日志、原生面积/时序/例外报告、物理原生结构证明、位文件与本报告；`deliverables/M1_SDRAM_SELFTEST_MANIFEST.json`登记位身份，硬件状态PENDING_M1_BOARD_TEST。

既有1389项历史原文、其中68项gzip逻辑内容、81项受保护资产，以及S1的222项封存均复核通过。新增S1板测另立补充索引，不覆盖旧证据或代写BURN_INDEX。

后续按实际M1板测决定：通过则恢复原SPI/SD初始化与受控LBA头扇区，再恢复标签全量与冻结双CRC，最后完整W2/S2显示及≥10分钟验收；失败则停在本层，按锁存错误做一个变量的对照。原完整A4启动停滞的根因仍未证明。
