KoneFly/eg4s20bg256-media-terminal/visual/m6_full_display_integration/doc/output/S1_SELFTEST_REPORT_20261006.md

# S1 独立启动自检交付（2026-10-06）

**已出独立诊断位，待上板；未宣称完整FDI修复。** 用户对75959E68已验基座的本次对照原话：“画面正常，p1是1，一直正常，那就切换思路，之前思路改了好几次一直不行该换了”。这证明同一显示环境能运行已验基座；未收到明确时长，不扩写≥10分钟新实测。

本轮切换到最小自检，隔离包 `experiments/startup_selftest_S1`，只编译11个HDL文件；复制8个只读资产（原PLL/时钟包装、数码管及HDMI IP/PHY/适配），新增3个诊断RTL。SPI、SDRAM、TF加载、W2/S2和网络不实例化，原完整工程及上游源均未修改。诊断彩条不等待label_ready、pixel_ready或W2提交；自检结果不回写完整功能链。

## 位文件与门禁

主板诊断位：`deliverables/M6_FDI_S1_20261006_4BA41B2F.bit`，629637字节，SHA256：

`4ba41b2fce390c31eea5cd1f8eb19332e56db424f3c751f682150ba8053f2a6d`

副板7175ECC3保持原样，受控TF卡不改写。S1不读取TF，也不依赖副板通信；当前画面应为固定竖向彩条，不能期待PCB线稿或频谱动态。BURN_INDEX仍由主人/规格方登记，本轮不代写。

| 最终独立TD | 结果 |
|---|---|
| MSlice / 正余量 | 691/4900，余4209 |
| LUT / REG | 2181 / 1878 |
| ERAM9K / ERAM32K / DSP / PLL | 10 / 0 / 0 / 3 |
| Setup / Hold | +6.071ns / +0.003ns |
| Setup / Hold违例 | 0 / 0 |
| 最终原生告警 / 路由DRC | 未报告告警 / CLEAN |
| 精确CDC | 72条物理查询命中；6个有计时源的首级D端+63个冻结结果MC4/3端；误豁免与别名OPEN0 |

Hold只有3ps正余量，如实保留；0/0不代表板上裕量充分或硬件通过。两个PLL锁定首级寄存器有三个物理LUT数据引脚，没有同步计时源，原生例外总路径为0；门级源锥证明只来自硬PLL extlock及组合逻辑，并逐FF映射到首级数据端。此项不是把空查询当命中，也不通过宽泛clock-group豁免消除问题。

原生计数审计确认加一DUT和反码参考各29个寄存器，未合并；反码参考29条数据锥都是LOGIC、没有RIPPLE进位路径，三路LFSR各15位保留。加一DUT使用原生进位资源，便于与参考交叉比较。证据见最终 `BIST_NATIVE_AUDIT.json`。此审计不证明实际烧录内容或板上计数传播。

## 板上一次记录

只换主板烧上述S1，连接HDMI-B。置SW0=1，确认d0=**05465**、d7=**65280**；KEY1按住约1秒放开，等2秒逐页读取，每页至少等0.3秒。KEY1是RTL名称，对应沿用052接线的丝印KEY2。SW[3:1]从000到111依次为d0至d7。

| 页 | 含义 | 正常预期 |
|---|---|---|
| d0 | S1识别 | 05465 |
| d1 | 32767个CTRL周期对应的基准周期数 | 约32767，允许±2 |
| d2 | 32767个MEM周期对应的基准周期数 | 约32767，允许±2 |
| d3 | 32767个PIXEL周期对应的基准周期数 | 约65014，允许±2 |
| d4 | 已捕获9999、65535、65536、499999的四位标志 | 00015 |
| d5 | 有效/锁定/复位/不一致/停钟状态 | 健康全就绪16639，位定义见下 |
| d6 | 首个停止结果的DUT低16位 | 41247 |
| d7 | 固定高位校准 | 65280 |

SW0=0不会切换时钟或停视频，只把部分页换为参考读数：P4为DUT高13位（正常7），P5为参考高13位（正常7），P6为参考低16位（正常41247）；其他页数值不变。请记录彩条是否出现，以及d1～d6；若d4/d5异常，再补P4～P6。正常后隔10秒复读d4/d5/d6，随后≥10分钟稳定并KEY1复现。失败也保留完整读数，不只反馈“黑屏”。

测量公式为 `源频率 ≈ 基准频率 × 32767 / 读数`。以板载基准50MHz计算，CTRL/MEM应50MHz、PIXEL应25.2MHz；它是相对测量，不是外部仪器校准的绝对频率。源端LFSR避免依赖CTRL宽加法；基准间隔计数仍为16位加一，不能把测量子系统自身无误当作前提。读数必须结合d5的valid/stale判断，旧有效值不能证明时钟仍在运行。

| d5位 | 含义 |
|---|---|
| 0、1、2 | CTRL、MEM、PIXEL测量已取得完整周期 |
| 3、4、5 | 网络PLL锁定、视频/音频PLL组合锁定、HDMI IP视频输入锁定（均同步到基准域） |
| 6、7 | CTRL复位已释放、冻结结果已捕获 |
| 8 | 首个计数DUT/参考不一致，置位为异常 |
| 9、10 | 武装后CTRL复位重现、网络PLL解锁，置位为异常 |
| 11、12、13 | CTRL、MEM、PIXEL事件超出65535基准周期窗口，置位表示停钟/过慢或测量未更新 |
| 14 | 复位监视已武装 |
| 15 | 固定0 |

## 软件与证据口径

最终 `sim/core_final` 使用Verilator5.032、**--assert**，实际编译输入四文件SHA已绑定并留存副本。覆盖从零到499999、16位跨界、独立参考一致、50/100/25MHz、停钟恢复、运行后CTRL复位和PLL解锁、KEY1清除、强制计数错误的首个不一致快照，以及两帧各307200像素/480行末/1帧首/非零彩条。加密HDMI内部没有被此软件测试验证。早期探路未启用断言，不作为PASS证据；随后断言捕获TB无尺寸常量导致的宽度判据问题，仅修订TB为29位常量，失败日志保留。诊断RTL没有因此改动。

四个核心模块按Verilog2005默认严格告警口径lint通过；整体应用-Wall、接口桩边界lint0错误/**165警告OPEN**，原文保留，不以全局豁免宣称零告警。冻结HDMI/PHY/PLL及数码管资产SHA一致，未修饰原源消告警。

初次综合没有正确加载SDC（Constraint File为空），作为过程证据保留，不作签核；check阶段使用显式实际路径重新加载，综合Setup+5.488/Hold+0.644、0/0。place为689MSlice、Setup−0.521/Hold−0.011、2/13，旧逻辑别名过程告警473条保留。按实际Q/FF数据选择重新映射后route为691MSlice、+6.071/+0.003、0/0；最终bit复核同一HDL、物理SDC、面积和时序，原生72条约束查询及范围审计通过。

既有1389项封存内容与81项保护资产复核；其中68项历史原文现为gzip，按解压字节和原SHA核验，没有恢复/覆盖旧路径。当前S1索引另封存全部RTL、TB、脚本、过程日志、原生数据库/网表、软件日志和交付位，不改A2/A3/A4历史封存。

## 后续分支

- 彩条、三路测量、计数参考全通过：接入冻结SDRAM引擎做初始化及有限BL8写读；通过后才接TF和双CRC，再恢复完整W2/S2。S1通过不能证明完整集成必然通过。
- 彩条正常、计数或CTRL/MEM测量异常：聚焦CTRL出口/复位/计数实现，用最小工程单变量对照；不改SPI/SDRAM驱动。
- 计数和测量正常、HDMI无信号：固定视频输入已与加载解耦，针对视频输入锁定、PLL及显示物理链排查。
- d5出现计数不一致：d6/P4与P6/P5保留首个失败点，停止计数，后续无需追读快速变化数。

本位是新思路的第一层诊断，不是完整功能交付，也没有代签任何S1板测结果。
