KoneFly/eg4s20bg256-media-terminal/visual/pcb_dynamic_layer/doc/output/V2_MEASUREMENT_REPORT.md

# V2 独立测量报告已归档

用户已批准 W1 整体出列，当前包只剩 W2 多周期版。

原完整报告及 V2 RTL/验证/黄金/TD 证据保留在 [V2 历史报告](../../archive/v2/doc/output/V2_MEASUREMENT_REPORT.md)。当前交付数字见 [W2 多周期报告](W2_MULTICYCLE_REPORT.md) 与 sim/td_result_mc.json。

V2 的两模块结果属于历史证据，不作为当前 W2 门禁结果。
