KoneFly/eg4s20bg256-media-terminal/visual/tidal_particles/VERIFICATION_CONTRACT.md

# M5 验证契约

## 场景列表

| ID | 刺激 | 可观察检查项 |
|---|---|---|
| P01 | 异步复位、释放两拍、未见VS低 | valid/pixel=0；seed/slot状态可经首两帧公开输出验证 |
| P02 | 固定8能量[64,128,0…]首两次commit | seed B387/CE1E、cursor2/4；slot0/1位置65,349/99,361→64,346/101,356，公开像素锚全中 |
| P03 | 全0连续16场 | 无外环强光、无新粒子，已有粒子12次更新后消亡，仅内环/稀疏星点 |
| P04 | 全255连续128场 | 活动槽≤16、无x/y/age越界、LFSR非0；每场最多2槽重置 |
| P05 | 16槽重叠注入 | 高slot颜色优先，3×3核/距离4光晕/8px尾迹按固定像素锚 |
| P06 | 8方向单热能量逐一输入 | 只有对应外环方向增亮，映射顺序上→顺时针8向；边界优先级明确 |
| P07 | 均匀128能量 | 8个环坐标固定值与reference锚一致；内环/背景分离 |
| P08 | 静音→强能量→静音 | 外环灭/亮/灭；考虑014 release尾巴，低于32后不再发射，旧粒子最长12场消亡 |
| P09 | KEY0循环主题 | 在场提交后色盘0→1→2→0，坐标/寿命不变 |
| P10 | KEY1冻结、KEY2恢复 | 冻结时粒子/能量/LFSR/cursor/phase保持；恢复提交后继续推进 |
| P11 | 按键commit前/同沿/后1拍 | 同沿提交旧pending，下一场应用新键；无帧内跳色 |
| P12 | `sw_level[1:0]` 0/1/2/3 | 外环半径按能量右移缩小，阈值按右移后值，保留高位无影响 |
| P13 | video_timing_data寄存器源直连 | x=0..639逐拍对齐Task020/030，无一像素错位；DE消隐pixel/valid=0 |
| P14 | DE过长/额外行、帧中复位 | 越界不回绕，下一VS恢复完整输出；公开端口无X/Z |

## TestBench架构要求

本模块像素为组合输出：TB在下降沿更新激励/稳定后、下一上升沿之前检查公开像素；状态寄存器在上升沿NBA后检查，但不能直接读DUT内部作为唯一黄金。固定首两帧state锚与21像素锚来自reference；环形方向用手工八向坐标表，TB不能复制DUT `max/min` 判断链当自证。16槽重叠与静音尾巴检查最终输出及活跃计数，不只检查pending。

fail-fast：第一失败即报告场景/帧/x/y/期望/实际并停止；同类消息限流。每场景有看门狗。默认不开VCD；编译失败不能运行旧vvp。`sim/run.sh`以最新SIM_RUN_TEMPLATE.sh为骨架，`PROFILE=quick|full`、默认quick；结构化结果区分PASS/FAIL/TIMEOUT。

## 边界与规模覆盖

本任务无可变长度报文/存储流。仍检查位选别名：cursor[3:0]覆盖0..15、slot band仅slot[2:0]、phase[5:0]覆盖0..63、age到12时失活；32场以上序列覆盖cursor多次回绕，64场以上覆盖phase回绕。发射字段只在cursor/cursor+1两槽写入，其他槽不得污染。

## 分层与时间预算

| 层 | 内容 | 预估墙钟/方法 |
|---|---|---|
| L0 | 编译＋首两场状态/静音/8方向固定锚 | 目标<30秒；可缩短视频激励但不缩短真实边界向量 |
| L1 | P01–P14所有模块场景＋32场cursor回绕 | 目标<5分钟；需要实际量测并登记 |
| L2 | 64场phase回绕、128场强能量长跑、完整640×480抽帧黄金、首次变异 | 后台执行；预计Icarus>5分钟，先评估/使用Verilator |

## 提速措施

粒子状态逻辑L0/L1用Icarus；逐像素纯组合环用Python/Node固定坐标与范围穷举作独立证据。L2多帧全画面预计超过5分钟，立项即评估WSL/Verilator与HDMI stub，按SIMULATION_COST_POLICY选择。首次新增判据跑变异证明TB杀伤力，此后常规回归不重复全部变异。L0/L1禁止删掉零能量、age12与坐标回绕等真实边界。

## 验收门槛

P01–P14全部实际PASS、0错误0警告、固定golden副本逐位一致，模块TD资源和时序符合Brief。L0/bit登记/后续板级门禁依据TASK_KICKOFF当前版本执行；本模块无bit，集成任务负责。未有板级证据不声称M5上板。

## 时序要求

TD直接报告Setup/Hold WNS及违例端点，负裕量不得放行。板级集成与036稳定版对照，最差路径不得因M5恶化而不披露；“沿用旧版”不能作为接受负裕量的理由。当前036 P1的+0.099ns只作风险底数，正式集成重新布线后重测。
