KoneFly/eg4s20bg256-media-terminal/visual/m6_full_display_integration/reference/round1_fat32/fdi_fat32_file_streamer.v

`timescale 1ns/1ps

module fdi_fat32_file_streamer #(
    parameter integer MAX_VISITED_CLUSTERS = 8192
) (
    input  wire        clk,
    input  wire        rst_n,
    input  wire        file_start,
    input  wire [31:0] first_cluster,
    input  wire [31:0] file_size,
    input  wire [7:0]  sectors_per_cluster,
    input  wire [31:0] fat_start_lba,
    input  wire [31:0] data_start_lba,
    input  wire [31:0] max_cluster,
    output wire        file_busy,
    output reg         file_done,
    output reg         file_valid,
    output reg  [7:0]  file_byte,
    output reg  [31:0] file_byte_offset,
    output reg  [7:0]  fs_error,
    output reg         sector_req,
    output reg  [31:0] sector_lba,
    input  wire        sector_busy,
    input  wire        sector_valid,
    input  wire [7:0]  sector_byte,
    input  wire [8:0]  sector_byte_index,
    input  wire        sector_done,
    input  wire [7:0]  sector_error
);
    localparam ERR_NONE              = 8'h00;
    localparam ERR_SECTOR            = 8'h10;
    localparam ERR_FAT_LOOP          = 8'h23;
    localparam ERR_CLUSTER_RANGE     = 8'h24;
    localparam ERR_EARLY_EOF         = 8'h25;
    localparam ERR_VISITED_EXHAUSTED = 8'h26;

    localparam ST_IDLE       = 4'd0;
    localparam ST_DATA_REQ   = 4'd1;
    localparam ST_DATA_WAIT  = 4'd2;
    localparam ST_FAT_REQ    = 4'd3;
    localparam ST_FAT_WAIT   = 4'd4;
    localparam ST_FAT_PARSE  = 4'd5;
    localparam ST_MAP_SHIFT  = 4'd6;
    localparam ST_FINISH     = 4'd7;

    localparam integer CHAIN_COUNT_WIDTH = $clog2(MAX_VISITED_CLUSTERS + 1);

    reg [3:0] state;
    reg [31:0] current_cluster;
    reg [31:0] remaining_bytes;
    reg [7:0] sector_in_cluster;
    reg [8:0] fat_entry_offset;
    reg [7:0] fat_byte0, fat_byte1, fat_byte2;
    reg [3:0] fat_byte3;
    reg [CHAIN_COUNT_WIDTH-1:0] chain_count;
    reg final_chain_check;
    // SPC 由挂载器验证为二次幂；逐拍移位复用地址寄存，避免32x8乘法DSP。
    reg [31:0] map_value;
    reg [7:0] map_spc;

    assign file_busy = (state != ST_IDLE);

    task finish_with_error;
        input [7:0] code;
        begin
            fs_error <= code;
            state <= ST_FINISH;
        end
    endtask

    task advance_to_next_cluster;
        input [31:0] cluster_value;
        begin
            chain_count <= chain_count + 1'b1;
            current_cluster <= cluster_value;
            map_value <= cluster_value - 2;
            map_spc <= sectors_per_cluster;
            state <= ST_MAP_SHIFT;
        end
    endtask

    always @(posedge clk or negedge rst_n) begin
        if (!rst_n) begin
            state <= ST_IDLE;
            file_done <= 1'b0;
            file_valid <= 1'b0;
            file_byte <= 8'd0;
            file_byte_offset <= 32'd0;
            fs_error <= ERR_NONE;
            sector_req <= 1'b0;
            sector_lba <= 32'd0;
            current_cluster <= 32'd0;
            remaining_bytes <= 32'd0;
            sector_in_cluster <= 8'd0;
            fat_entry_offset <= 9'd0;
            fat_byte0 <= 8'd0;
            fat_byte1 <= 8'd0;
            fat_byte2 <= 8'd0;
            fat_byte3 <= 4'd0;
            chain_count <= 0;
            final_chain_check <= 1'b0;
            map_value <= 0;
            map_spc <= 1;
        end else begin
            file_done <= 1'b0;
            file_valid <= 1'b0;
            sector_req <= 1'b0;

            if (state == ST_DATA_WAIT && sector_valid && remaining_bytes != 0) begin
                file_valid <= 1'b1;
                file_byte <= sector_byte;
                file_byte_offset <= file_size - remaining_bytes;
                remaining_bytes <= remaining_bytes - 1'b1;
            end

            if (state == ST_FAT_WAIT && sector_valid) begin
                if (sector_byte_index == fat_entry_offset)
                    fat_byte0 <= sector_byte;
                else if (sector_byte_index == fat_entry_offset + 1'b1)
                    fat_byte1 <= sector_byte;
                else if (sector_byte_index == fat_entry_offset + 9'd2)
                    fat_byte2 <= sector_byte;
                else if (sector_byte_index == fat_entry_offset + 9'd3)
                    fat_byte3 <= sector_byte[3:0];
            end

            case (state)
                ST_IDLE: if (file_start) begin
                    fs_error <= ERR_NONE;
                    file_byte_offset <= 32'd0;
                    remaining_bytes <= file_size;
                    sector_in_cluster <= 8'd0;
                    chain_count <= 1;
                    final_chain_check <= 1'b0;
                    if (file_size == 0) begin
                        state <= ST_FINISH;
                    end else if (first_cluster < 2 || first_cluster > max_cluster ||
                                 sectors_per_cluster == 0 ||
                                 (sectors_per_cluster & (sectors_per_cluster - 1'b1)) != 0) begin
                        finish_with_error(ERR_CLUSTER_RANGE);
                    end else begin
                        current_cluster <= first_cluster;
                        map_value <= first_cluster - 2;
                        map_spc <= sectors_per_cluster;
                        state <= ST_MAP_SHIFT;
                    end
                end
                ST_MAP_SHIFT: if (map_spc != 1) begin
                    map_value <= map_value << 1;
                    map_spc <= map_spc >> 1;
                end else begin
                    sector_lba <= data_start_lba + map_value;
                    state <= ST_DATA_REQ;
                end
                ST_DATA_REQ: if (!sector_busy) begin
                    sector_req <= 1'b1;
                    state <= ST_DATA_WAIT;
                end
                ST_DATA_WAIT: if (sector_done) begin
                    if (sector_error != 0) begin
                        finish_with_error(ERR_SECTOR);
                    end else if (remaining_bytes == 0 ||
                                 (remaining_bytes == 1 && sector_valid)) begin
                        final_chain_check <= 1'b1;
                        sector_in_cluster <= 8'd0;
                        fat_entry_offset <= {current_cluster[6:0], 2'b00};
                        sector_lba <= fat_start_lba + (current_cluster >> 7);
                        state <= ST_FAT_REQ;
                    end else if (sector_in_cluster + 1'b1 < sectors_per_cluster) begin
                        sector_in_cluster <= sector_in_cluster + 1'b1;
                        sector_lba <= sector_lba + 1'b1;
                        state <= ST_DATA_REQ;
                    end else begin
                        sector_in_cluster <= 8'd0;
                        fat_entry_offset <= {current_cluster[6:0], 2'b00};
                        sector_lba <= fat_start_lba + (current_cluster >> 7);
                        state <= ST_FAT_REQ;
                    end
                end
                ST_FAT_REQ: if (!sector_busy) begin
                    sector_req <= 1'b1;
                    state <= ST_FAT_WAIT;
                end
                ST_FAT_WAIT: if (sector_done) begin
                    if (sector_error != 0)
                        finish_with_error(ERR_SECTOR);
                    else
                        state <= ST_FAT_PARSE;
                end
                ST_FAT_PARSE: begin
                    if (final_chain_check) begin
                        final_chain_check <= 1'b0;
                        if ({fat_byte3[3:0], fat_byte2, fat_byte1, fat_byte0} >= 28'hffffff8)
                            state <= ST_FINISH;
                        else if ({4'd0, fat_byte3[3:0], fat_byte2, fat_byte1, fat_byte0} < 2 ||
                                 {4'd0, fat_byte3[3:0], fat_byte2, fat_byte1, fat_byte0} > max_cluster)
                            finish_with_error(ERR_CLUSTER_RANGE);
                        else
                            finish_with_error(ERR_FAT_LOOP);
                    end else if ({fat_byte3[3:0], fat_byte2, fat_byte1, fat_byte0} >= 28'hffffff8) begin
                        finish_with_error(ERR_EARLY_EOF);
                    end else if ({4'd0, fat_byte3[3:0], fat_byte2, fat_byte1, fat_byte0} < 2 ||
                                 {4'd0, fat_byte3[3:0], fat_byte2, fat_byte1, fat_byte0} > max_cluster) begin
                        finish_with_error(ERR_CLUSTER_RANGE);
                    end else if (chain_count >= MAX_VISITED_CLUSTERS[CHAIN_COUNT_WIDTH-1:0]) begin
                        finish_with_error(ERR_VISITED_EXHAUSTED);
                    end else if ({4'd0, fat_byte3[3:0], fat_byte2, fat_byte1, fat_byte0} == current_cluster) begin
                        finish_with_error(ERR_FAT_LOOP);
                    end else begin
                        advance_to_next_cluster({4'd0, fat_byte3[3:0], fat_byte2, fat_byte1, fat_byte0});
                    end
                end
                ST_FINISH: begin
                    file_done <= 1'b1;
                    state <= ST_IDLE;
                end
                default: state <= ST_IDLE;
            endcase
        end
    end
endmodule
