KoneFly/eg4s20bg256-media-terminal/(commit log)

2026-09-29 Archive verified EG4S20BG256 board deliveries
2026-10-06 deliveries: 新增 task_043 W7 主线冻结基底 467a01bc（2026-10-06 上板确认）
    - 快照 deliveries/043_w7_mainline/：bit + 约束 + 80 RTL + 最终 TD 报告
    - W1–W7 + 转场 P 系列全接线；含 046 加载提速、字幕线、参数调节
    - 更新 DELIVERY_INDEX.md 与 SHA256SUMS.txt（361 项）
2026-10-14 policy: 纳入范围扩为「基线 + 重大迭代版本」；文档不纳入仓库
    - README 说明纳入/不纳入边界，并标注 2026-10-14 状态（自 10-06 起无新增上板 PASS）
    - 文档类（DECISION_LOG / 交互规格等）改为本地维护，不进本仓库
2026-10-14 policy: 纳入范围扩为「基线 + 重大迭代版本」；文档不纳入仓库
    - 索引加「状态」列；新增「待纳入」：stage12 整机候选（重大迭代，未出 bit）
    - 记录副板 bit F77781CD 不纳入的原因（双板数据面未验，不构成数值正确的上板 PASS）
    - 记录冻结树一致性核对结论（2026-10-14：本地生产树最后改动 2026-10-05，早于 10-06 推送）
2026-11-04 deliveries: 新增 073 最终提交版（主板 F3.5 / 副板 R69）双板完整工具链
    - 主板 F3.5：PLB 2390/2450，Setup 3.750 / Hold 0.230 ns，64 个 .v + 3 个头文件
    - 副板 R69：PLB 2431/2450，Setup 0.736 / Hold 0.042 ns，41 个 .v + 7 个头文件
    - 含 rtl / constraints / td_run / tb / scripts / tools / verification / validation / model / bit
    - 厂商加密 IP 按政策剔除，构建需本地合法工具链
    - 新增 docs/ 技术文档（硬件工具链、ANC 验收、FPC 改造、中继板规格）
    - README 补写作品简介与口径边界；SHA256SUMS 全量重算（795 项）
2026-11-04 visual: 归档旧方向 13 个渲染器原型与 m6 集成源码
    - 2026-10-11 已转向，仅作过程留档
    - 只纳入 RTL/文档；实验副本、门级网表、生成的 diff 补丁均未纳入
    - 厂商加密 IP（HDMI 发送器、UDP 协议栈）按政策剔除
    - SHA256SUMS 全量重算（1913 项）
